SayatAbdikul/Ushqyn/README.md

# Ushqyn (Ұшқын)

> *Ushqyn* — Kazakh for **spark**: tiny, energetic, the genesis of fire.

An INT8 TinyML accelerator targeting the Tang Nano 20K. The selected KWS/VWW
release uses a 27 MHz cached-weight co-issue engine, compiler-managed retention,
SDRAM DMA and a 256-byte UART bridge at 750,000 baud. Its matched board screen
passes **14/14 exact executions**, with median device execution of **41.450 ms
KWS** and **79.898 ms VWW**. The
[selected release](hardware/releases/phase6/selected/README.md) includes the tested
image, source and fixture hashes, build recipe and fresh native validation.
These measurements exclude host loading/readback and remain short-screen results.
Full endurance, board energy and a new architectural contribution remain open.

The earlier reset-corrected G3 on-chip release separately passed MLP → SmallCNN →
MLP with 1,000 exact jobs per stage and a 10,000-image SmallCNN run. The Phase 4
release established exact autonomous SDRAM execution of all 22 KWS and 58 VWW
nodes. See the
[Phase 3 board closure](docs/research/PHASE_3_CLOSURE.md),
[Phase 4 status](docs/research/PHASE_4_STATUS.md),
[Phase 5 status](docs/research/PHASE_5_STATUS.md),
[Phase 6 status](docs/research/PHASE_6_STATUS.md),
[Phase 3 SmallCNN record](docs/research/PHASE_3_STATUS.md) and
[research roadmap](docs/RESEARCH_ROADMAP.md).

## Status

| Workload | Software quality | Board-system RTL | Tang Nano 20K |
|---|---|---|---|
| **MLP** (784→12→32→10 MNIST) | 94.84% static INT8 on 10K | 1,000 exact jobs in Phase 2; retained in current RTL | Two 1,000-job stages exact; 7,316 core cycles |
| **SmallCNN** (Conv→Pool→Conv→Pool→FC) | 96.40% static INT8 on 10K | 10,000 exact jobs, eight layer boundaries checked | Full 10K set + 1K repeated jobs exact; 96.40% accuracy; 118,267 core cycles |
| **KWS / VWW** | Full-set software INT8 quality recorded | Selected engine runs pinned/stress fixtures with fixed and sampled stalled RAM; original layer-oracle evidence retained | Selected 27 MHz image: 14/14 matched exact executions, 41.450 ms KWS / 79.898 ms VWW; short-screen qualification |

The current SmallCNN result uses an independent centered-integer oracle,
source-hashed RTL and a separately calibrated 10,000-image quality evaluation.
The [physical workflow](hardware/PHYSICAL.md) separates device counters,
host latency and remaining measurement/architecture work.

## Selected accelerator

From the repository root:

```bash
make p6-selected-check PYTHON="$PWD/.venv/bin/python3"
make p6-selected-native PYTHON="$PWD/.venv/bin/python3"
```

The first command extracts the pinned bitstream and local generated SDRAM IP,
then verifies all 18 physical source identities, four fixtures and the signed
board records. The second builds the selected RTL and runs KWS/VWW pinned/stress
inputs with fixed RAM and stalled seed 6063. Neither command accesses the board.
The extracted image is `work/phase6/selected-release/selected_27mhz.fs`; a fresh
Gowin build uses `hardware/phase6/build_selected27.tcl`. Follow the
[release instructions](hardware/releases/phase6/selected/README.md) for identity
checks and the distinction between the tested image and a newly routed build.

The latest [implementation decision round](docs/research/PHASE_6_IMPLEMENTATION_DECISION_ROUND_2026_10_01.md)
keeps factorization and resident-preemption experiments as research evidence.
The selected release uses the original validated dense programs.

## Historical v1 architecture

The feature list and workflow below describe the older instruction-set design,
not the current board ABI. Use [physical reproduction](hardware/PHYSICAL.md) for
the active accelerator.

## Key Features (legacy)

- **8-instruction ISA**: `LOAD_V`, `LOAD_M`, `STORE`, `GEMV`, `RELU`, `CONV2D_CFG`, `CONV2D_RUN` (with fused ReLU), `MAXPOOL`
- **Tile-based compute**: 8-element tiles (FPGA) or 32-element tiles (simulation), BSRAM-backed
- **Dynamic per-tensor max-abs quantization**: int32 → int8 with reciprocal-multiply rounding (Q8.24 fixed point)
- **Unified DRAM**: Single 32 KB memory (FPGA: Gowin_SP BRAM + UART loader; sim: `$readmemh` register array)
- **Modular execution units**: One unit per opcode, each independently testable in cocotb
- **Compiler toolchain**: ONNX → assembly → DRAM image, with bit-exact golden-model reference

## Quick Start

### Run the CI tier (no simulator required)
```bash
make ci PYTHON=/absolute/path/to/.venv/bin/python3  # compiler, generated-file and selected-release checks
make help       # full target list
```

This is what `.github/workflows/ci.yml` runs on every push. It locks in:
- the single-source ISA spec (`compiler/isa_spec.py` ↔ `rtl/i_decoder.sv` drift detection),
- the unified ONNX walker (`compile.py` consumes maps from `dram.py`),
- the profile-based `AcceleratorConfig` (sim ↔ fpga),
- and the SmallCNN end-to-end golden contract.

### Run a per-unit cocotb test
```bash
# Conv2D execution: bit-exact match vs golden on relu_flag=0/1
cd test/cocotb_tests
./make_venv.sh TEST_TARGET=conv2d_execution

# MaxPool execution: NCHW layout, bit-exact match vs golden
./make_venv.sh TEST_TARGET=maxpool_execution
```

### Run the SmallCNN end-to-end through compiler + golden model
```bash
cd compiler
python3 train_and_eval_cnn.py     # Train + evaluate (PyTorch + golden model)
```

### Run the trained MLP end-to-end through simulation RTL
```bash
cd test/heavy_test_fpga
make run_test NUM_IMAGES=20         # Full pipeline through FPGA-tier RTL
```

### Compile your own ONNX model
```bash
cd compiler
python3 compile.py model.onnx assembly_code.asm
python3 -c "from assembler import assemble_file; assemble_file('assembly_code.asm', 'output.hex')"
```

## Project Structure

```
ushqyn/
├── src/                            # FPGA synthesis source (Gowin EDA)
│   ├── fpga_top.sv                # FPGA top-level (UART + accelerator)
│   ├── tinyml_accelerator_top_fpga.sv
│   ├── top_gemv.sv                # GEMV core (BSRAM-optimized)
│   ├── simple_memory.sv           # Gowin_SP BRAM + UART loader
│   ├── Gowin_SDPB_32.sv           # BSRAM IP wrapper
│   └── ...                         # Decoder, exec units, UART, etc.
│
├── rtl/                            # Simulation RTL (Verilator + cocotb)
│   ├── tinyml_accelerator_top.sv  # Sim top
│   ├── i_decoder.sv               # 8-opcode decoder (incl. CONV2D_CFG/RUN, MAXPOOL)
│   ├── accelerator_config_pkg.sv  # (gitignored — regenerated by generate_config.py)
│   ├── execution_unit/            # CNN-capable simulation execution path
│   │   ├── modular_execution_unit.sv
│   │   ├── conv2d_execution.sv    # 2D convolution + fused ReLU + per-tensor quant
│   │   ├── maxpool_execution.sv   # Sliding-window NCHW max-pool
│   │   ├── gemv_execution.sv      # FC / Gemm path
│   │   ├── load_execution.sv, store_execution.sv, relu_execution.sv
│   │   └── buffer_controller.sv
│   └── fpga_modules/              # FPGA-targeted simulation mocks (MLP only today)
│       ├── gemv_unit_core.sv      # BSRAM-backed GEMV core
│       ├── Gowin_SDPB_32.sv       # Sim mock of Gowin BSRAM
│       └── ...                     # No conv2d/maxpool yet — see "FPGA path" below
│
├── compiler/                       # Python toolchain
│   ├── compile.py                 # ONNX → assembly
│   ├── assembler.py               # Assembly → 64-bit machine code
│   ├── disassembler.py            # Reverse: bytes → mnemonic
│   ├── dram.py                    # save_all_initializers_to_dram + DRAM hex writer
│   ├── golden_model.py            # Bit-exact Python reference (RTL contract)
│   ├── helper_functions.py        # quantize_int32_to_int8_rtl_exact + ONNX helpers
│   ├── model.py                   # MLP and SmallCNN PyTorch definitions
│   ├── train_and_eval_cnn.py      # Train SmallCNN, eval through full toolchain
│   └── test_cnn_golden.py         # End-to-end pytest (LOAD_V count, FC bias DRAM, NumPy shadow chain)
│
├── test/
│   ├── cocotb_tests/              # Per-unit cocotb tests
│   │   ├── test_conv2d_execution.py     # NEW — Patch F regression
│   │   ├── test_maxpool_execution.py    # NEW — Patch G regression
│   │   ├── test_execution_unit.py       # MLP integration
│   │   └── test_golden_comparison.py    # Top-level MLP cocotb
│   ├── conv2d_execution_tb.cpp / _wrapper.sv    # Verilator C++ tb
│   ├── maxpool_execution_tb.cpp / _wrapper.sv   # Verilator C++ tb
│   ├── heavy_test_fpga/           # Full MNIST integration on FPGA-tier RTL (MLP)
│   ├── heavy_test/                # Full MNIST on simulation RTL (sim_only path)
│   └── new_unit_tests/            # Verilator C++ standalone unit tests
│
├── memory_tools/                   # UART loaders / readers for FPGA
├── docs/
│   ├── RTL_ARCHITECTURE.md        # Detailed RTL architecture
│   └── diagrams/                  # System diagrams
└── generate_config.py              # Source of truth for both rtl/accelerator_config_pkg.sv and compiler/accelerator_config.py
```

## Two RTL paths

| Path | Top module | Workloads | Targeted at |
|---|---|---|---|
| `rtl/` + `rtl/execution_unit/` | `tinyml_accelerator_top.sv` | **MLP + CNN** | Verilator/cocotb simulation |
| `rtl/fpga_modules/` (+ `src/` for synthesis) | `tinyml_accelerator_top_fpga.sv` (+ `fpga_top.sv`) | **MLP only** today | Gowin GW2AR-18 (Tang Nano 20K) |

The simulation RTL has the full 8-opcode CNN path. The FPGA path mirrors the MLP subset (`gemv_unit_core.sv` + supporting modules) at smaller TILE_ELEMS=8 and is the only one currently synthesizable. Bringing the CNN ops to FPGA requires porting `conv2d_execution.sv` / `maxpool_execution.sv` into `rtl/fpga_modules/` with TILE_ELEMS=8 and a Gowin BSRAM-backed accumulator (~2–4 days of focused work).

## Instruction Set

| Opcode | Mnemonic | Description | Notes |
|---|---|---|---|
| 0x00 | NOP | No-op (program terminator) | Zero word ends fetch |
| 0x01 | LOAD_V | Load vector from DRAM into a vector buffer | 18-bit length |
| 0x02 | LOAD_M | Load matrix from DRAM into a matrix buffer | rows × cols, cols padded to TILE_ELEMS |
| 0x03 | STORE | Write a vector buffer back to DRAM | 18-bit length |
| 0x04 | GEMV | `dest = quant(W·x + b)` | int32 accum, per-tensor max-abs scale |
| 0x05 | RELU | Element-wise `max(0, x)` | Standalone (used for FC ReLU) |
| 0x06 | CONV2D_CFG | Latch convolution geometry (fmap, channels, kernel, stride, pad) | Precedes CONV2D_RUN |
| 0x07 | CONV2D_RUN | Execute 2D convolution + bias + quant; `relu_flag` (bit 25) optionally fuses ReLU | Reads geometry from prior CONV2D_CFG |
| 0x08 | MAXPOOL | Sliding-window NCHW max pool | Operates on int8 directly, no rescale |

**Instruction encoding**: 64-bit little-endian word, opcode in bits [4:0]. The single source of truth for every opcode and field bit-layout is `compiler/isa_spec.py`. The assembler, disassembler, the golden-model decoder, and `rtl/i_decoder.sv` (regenerated by `tools/generate_i_decoder.py`) all read from that file. To add or change an opcode, edit `isa_spec.OPCODES`, run `python tools/generate_i_decoder.py`, and re-run `compiler/test_isa_spec.py` to confirm cross-consistency. See [docs/RTL_ARCHITECTURE.md](docs/RTL_ARCHITECTURE.md) for the per-opcode bit-layout tables.

## Module Hierarchy

```
tinyml_accelerator_top
├── fetch_unit                    Fetches 64-bit instructions from DRAM
├── i_decoder                     Decodes opcode + per-op fields
└── modular_execution_unit
    ├── buffer_controller         Vector + matrix buffer file management
    │   └── buffer_file (×N)      Tile-indexed BSRAM-backed buffers
    ├── load_execution            LOAD_V / LOAD_M orchestration
    │   ├── load_v.sv
    │   └── load_m.sv
    ├── gemv_execution            FC / Gemm tile streaming
    │   └── (sim) top_gemv  /  (FPGA) gemv_unit_core
    │       ├── pe.sv (×TILE_ELEMS)        — int8 × int8 multiplier
    │       ├── scale_calculator.sv         — recip = (127<<24)/max_abs
    │       └── quantizer_pipeline.sv       — int32 × Q8.24 → round → clamp int8
    ├── relu_execution            Standalone ReLU (FC outputs only)
    ├── conv2d_execution          2D conv + bias + quant (+ optional fused ReLU)
    │                              [simulation RTL only — not yet in fpga_modules/]
    ├── maxpool_execution         Sliding-window max pool (NCHW)
    │                              [simulation RTL only — not yet in fpga_modules/]
    └── store_execution           Buffer → DRAM write-back
```

## Compiler Toolchain

```
ONNX model
    │
    ▼
compile.py            (topological walk, emits assembly)
    │
    ▼
assembly file
    │
    ▼
assembler.py          (mnemonic → 64-bit machine code)
    │
    ▼
dram.py               (save_all_initializers_to_dram: weights, biases, instructions
                       packed into a single dram.hex DRAM image)
    │
    ▼
dram.hex              ──→  Loaded into RTL via $readmemh (sim) or UART (FPGA)
                      ──→  Executed by golden_model.execute_program (Python)
```

The compiler walks the ONNX graph in topological order, emits per-op instructions, and lays out weights/biases in a single shared DRAM region with a deterministic offset scheme (`compiler/accelerator_config.py::AcceleratorConfig`). The Python golden model decodes the same instruction stream and is **bit-exact** with the RTL on every operation — it serves as the contract that the RTL must satisfy.

## DRAM Memory Map

| Region | Default address | Contents |
|---|---|---|
| Instructions | `0x0000` | Program code (fetched by `fetch_unit`) |
| Inputs | `0x00C0` | Per-image input vector (loaded via LOAD_V) |
| Biases | `0x04C0` | All biases in topological order: conv1 → conv2 → … → fc |
| Outputs | `0x08C0` | Inference results (written by STORE) |
| FC Weights | `0x0940` | Gemm/MatMul weights, padded to TILE_ELEMS columns |
| Conv Weights | `0x3000` | Conv weights `[out_C, in_C·kH·kW]`, padded to TILE_ELEMS columns |

Addresses live in `generate_config.py::DEFAULT_CONFIG` and are emitted to both `rtl/accelerator_config_pkg.sv` and `compiler/accelerator_config.py`.

## Performance

### Simulation RTL (32-element tiles, CNN-capable)
- Bit-exact match against `compiler/golden_model.py` on the SmallCNN.
- ~1 M cycles/image at simulation rate (~5–10 k sim cycles/sec wall on a typical laptop with cocotb tracing on).

### FPGA build (Gowin GW2AR-18, MLP only)

| Metric | Value |
|---|---:|
| **Fmax** | 89.2 MHz |
| **Cycles / image (MLP)** | 25,470 |
| **Latency** | 0.286 ms/img (~3,500 img/s) |
| **LUT4** | 8,640 / 20,736 (42 %) |
| **BSRAM (18 Kb blocks)** | 43 / 46 (94 %) |
| **DSP** | 5 (1× MULT36X36 + 4× MULTADDALU18X18) |
| **MNIST accuracy** | 95 % on 10 000 images, 100 % bit-exact vs golden |

### Optimization timeline (MLP path on FPGA)

| Step | Cycles | Fmax | Notes |
|---|---:|---:|---|
| Baseline (BSRAM accum) | 43 996 | 67 MHz | Initial FPGA bring-up |
| FIND_MAX / CLEAR fix | 34 942 | — | −20.6 % cycles |
| A1–A4 (pipeline stages) | 36 221 | 84 MHz | +25 % Fmax |
| A6 (x_mem → BSRAM) | 37 501 | 91 MHz | +36 % Fmax |
| B1 (pack x_mem 4:1) | 29 301 | 86 MHz | −21.9 % cycles |
| B2 (prefetch x tile) | 25 470 | 89 MHz | −13.1 % cycles |

### CNN compiler-fix series (Patches A–D, F–J — 2026)

The CNN-capable simulation path was brought up over a sequence of focused patches:

| Patch | Scope | Result |
|---|---|---|
| **A** | `golden_model.py` cleanup; `disassembler.py` CNN ops | Lint clean, debug residue removed |
| **B** | Compiler bias data-flow rewrite (atomic): unified DRAM walker, no duplicate `LOAD_V`, TILE_ELEMS-driven padding | Strengthened end-to-end test (`test_cnn_golden.py`) goes red→green |
| **C** | Cross-link docstrings between `gemv` / `conv2d` / `load_m` | — |
| **D** | Conv→Relu lookahead skips non-consumer nodes (Constant) | Compiler emits correct `relu_flag` for both convs |
| **F** | RTL `relu_flag` plumbing (`i_decoder` → top → exec unit → conv2d) | 2/2 cocotb tests bit-exact vs golden |
| **G** | `maxpool_execution.sv` NCHW layout (was NHWC; mismatched conv2d output) | 2/2 cocotb tests bit-exact vs golden |
| **H** | `i_decoder` length width 10 → 18 bits (LOAD_V/STORE) | Lint clean; F+G regressions hold |
| **I** | `conv2d_execution.sv` `accum_ram` parameterized + overflow `$error` | F regression holds |
| **J** | `VECTOR_BUFFER_WIDTH` 8192 → 32768 + thread package param through exec units | **End-to-end RTL ↔ Golden bit-exact** on SmallCNN MNIST |

## Documentation

- **[docs/RTL_ARCHITECTURE.md](docs/RTL_ARCHITECTURE.md)** — Detailed RTL architecture, instruction-format bit layouts, FSM diagrams, optimization history
- **[docs/README.md](docs/README.md)** — Documentation index
- **[rtl/execution_unit/README.md](rtl/execution_unit/README.md)** — Execution-unit module guide (load / gemv / relu / store / **conv2d / maxpool**)
- **[test/heavy_test/README.md](test/heavy_test/README.md)** — Full-MNIST validation guide
- **[test/heavy_test_fpga/README.md](test/heavy_test_fpga/README.md)** — FPGA-tier simulation guide
- **[test/cocotb_tests/README.md](test/cocotb_tests/README.md)** — Per-unit cocotb test suite
- **[memory_tools/README.md](memory_tools/README.md)** — UART loader / reader

## Future Work

- **CNN on FPGA** — port `conv2d_execution.sv` and `maxpool_execution.sv` to `rtl/fpga_modules/` with TILE_ELEMS=8 and Gowin BSRAM-backed `accum_ram`. Estimated ~2–4 days of porting + bring-up.
- **Quantization quality** — per-channel weight quantization, asymmetric int8 for ReLU outputs, and calibration-based static activation scales would tighten the int8↔float32 gap on deeper networks. The SmallCNN sits at quantization noise today; bigger nets will need this.
- **Larger networks** — to run anything beyond a 2-conv-layer SmallCNN class, the ISA needs widening: `fmap_h`/`fmap_w` from 6 → ≥9 bits, channel fields from 6 → ≥10 bits, and `ADDR_WIDTH` from 16 → ≥24 (4 MB+ DRAM via PSRAM on FPGA). Tiny-YOLO targets are not feasible on the current ISA generation.

---

**Status (2026-05)**: Simulation RTL bit-exact against the Python golden model on a trained SmallCNN; FPGA build at 89 MHz with full-MNIST MLP validation. CNN ops on FPGA is the next bring-up milestone.
