SayatAbdikul/Ushqyn/hardware/PHYSICAL.md

# Tang Nano 20K physical validation

## Selected Phase 6 KWS/VWW release

The current fastest board-tested KWS/VWW image is the
[selected 27 MHz release](releases/phase6/selected/README.md), SHA256
`eaf74e99519d3dfac876bf21e9087dd005071bb8b8682d3f8ae6fb23bb76644d`.
It passes a 14-execution matched board screen with 41.450 ms KWS and 79.898 ms
VWW median device time. The release pins the cached-weight co-issue engine,
27 MHz host/PLL, 256-byte UART bridge at 750,000 baud and exact dense programs.

Run `make p6-selected-check PYTHON="$PWD/.venv/bin/python3"` to verify sources,
fixtures and signed records and extract `work/phase6/selected-release/selected_27mhz.fs`.
The relocation-safe fresh-build recipe is `hardware/phase6/build_selected27.tcl`.
No board is accessed by that verification or `make p6-selected-native`.
For future physical reproduction, supply the exact selected `.fs` and the
release's `fixtures/` directories to the Phase 6 board runner. A newly routed
image needs its own validation and must not inherit the archived measurements.
The phase-specific instructions below preserve the earlier release workflows.

## Phase 3 on-chip release

Use active target ID **8196** and the Phase 3 closure image at
`hardware/releases/phase3-closure/tinyml_v6_tang20k.fs`. The original
Phase 2–4 kernel-only bitstreams have the wrong KEY1 polarity; the reset-corrected v4
and line-buffer v5 images remain archived comparison baselines. The
[G3 closure record](../docs/research/PHASE_3_CLOSURE.md) identifies the
current source-matched board release.
Its SHA256 is
`4e3d6e9a47d872bfb65134fff9cdbb25c11dfc22bcbbf39db7d2c1ac9b61c0da`.

The board's KEY1 at pin 88 is **active high**. The wrapper initializes its
reset synchronizer at configuration, asserts reset while KEY1 is pressed,
and releases it after three clock edges. No button press is needed to begin
using the accelerator. This follows the inversion in Sipeed's
[UART reference](https://github.com/sipeed/TangNano-20K-example/blob/main/uart/src/uart_top.v).

## Build and program

Install the compiler/test environment and `tools/physical/requirements.txt`.
This execution used Gowin Education V1.9.11.03, Verilator 5.044,
openFPGALoader 1.1.1 and pyserial 3.5. From the repository root:

```sh
export USHQYN_ROOT="$PWD"
export DYLD_FRAMEWORK_PATH=/Applications/GowinIDE.app/Contents/Resources/Gowin_EDA/IDE/lib
export DYLD_LIBRARY_PATH="$DYLD_FRAMEWORK_PATH"
export GOWIN_SH=/Applications/GowinIDE.app/Contents/Resources/Gowin_EDA/IDE/bin/gw_sh
.venv/bin/python3 tools/phase2/build_gowin.py work/physical/new-build
.venv/bin/python3 tools/phase2/generate_target.py --check \
  --manifest work/physical/new-build/source-manifest.json
cd work/physical/new-build
"$GOWIN_SH" build.tcl
cd "$USHQYN_ROOT"
openFPGALoader -b tangnano20k --ftdi-serial 2025030317 --freq 2500000 -m -v \
  work/physical/new-build/tinyml_v2/impl/pnr/tinyml_v2.fs
```

For the frozen artifact, substitute
`hardware/releases/phase3-closure/tinyml_v6_tang20k.fs`. The test commands
below assume that frozen artifact was programmed. If you program a new build,
pass that exact new `.fs` to every `--bitstream` argument so the result records
its actual supplied hash. `-m` configures temporary
FPGA SRAM; the flash image is unchanged and returns after a power cycle.

The previous Phase 3 line-buffer image is separately archived at
`hardware/releases/phase3-linebuffer/tinyml_v5_candidate.fs` (SHA256
`fc6c90d3fb162eadfa042ecbfc1d89277c3a7a0af09fbc44a377c1fe90c81164`).
It passed RTL simulation, Gowin routing and 13,000 exact physical inferences
plus 61 diagnostics. Its
[separate board record](../docs/research/PHASE_3_LINEBUFFER_PHYSICAL.md)
documents that earlier rerun. The closure v6 image passed the same physical
suite and is the active release. Keep new runs in their own report directory.

Close UART sessions before programming. Keep the successful programmer log
with the bitstream SHA256. The UART protocol reports the ABI, but cannot
read back a configuration hash.

The tested USB debugger serial is `2025030317`. On this Mac,
`/dev/cu.usbserial-20250303171` is the FPGA UART; channel `...170` is JTAG.
Other boards/hosts may enumerate differently. Pins are clock 4, KEY1 88,
UART RX 70 and TX 69. The FPGA part is `GW2AR-LV18QN88C8/I7`, revision C
as detected by JTAG; the PCB revision is unknown.

The six user LEDs are active-low in this accelerator image. `led[0]` lights
while the engine is busy; `led[4]` pulses for one clock at a layer boundary;
`led[5]` lights when the engine reports a nonzero error. `led[1]` through
`led[3]` stay off. A high output pin therefore means the corresponding LED
is off.

## Repeat the checks

Prepare the current-target model fixtures with the commands in
[Phase 2](PHASE_2.md) and [Phase 3](PHASE_3.md). The MLP preparation requires
the original locally held weight file. Then:

```sh
.venv/bin/python3 tools/physical/run_models.py \
  --port /dev/cu.usbserial-20250303171 \
  --fixture work/phase2/mlp --fixture work/phase3/smallcnn \
  --fixture work/phase2/mlp --jobs 1000 \
  --bitstream hardware/releases/phase3-closure/tinyml_v6_tang20k.fs \
  --report work/physical/model-switch.json

.venv/bin/python3 tools/physical/run_checks.py \
  --port /dev/cu.usbserial-20250303171 \
  --fixture work/phase2/mlp --fixture work/phase3/smallcnn \
  --bitstream hardware/releases/phase3-closure/tinyml_v6_tang20k.fs \
  --report work/physical/checks.json
```

`run_checks.py` verifies six patterns across all 32 KiB, malformed-frame
recovery, busy ownership, ABORT/RESET, nine directed kernel geometries
(three runs each), and every MLP/SmallCNN layer for three inputs. Individual
layer counters include that isolated RUN's startup/HALT overhead; they are
not additive measurements of uninterrupted whole-model execution.

For the complete SmallCNN accuracy set, either generate a new 10,000-case
fixture with `tools/phase3/prepare_smallcnn.py --jobs 10000`, or join the
already frozen full-set oracle to the current fixture:

```sh
.venv/bin/python3 tools/physical/prepare_smallcnn_quality.py
.venv/bin/python3 tools/physical/run_models.py \
  --port /dev/cu.usbserial-20250303171 \
  --fixture work/physical/smallcnn-full --jobs 10000 \
  --bitstream hardware/releases/phase3-closure/tinyml_v6_tang20k.fs \
  --report work/physical/smallcnn-full.json
```

The join checks software image, model, calibration and dataset identity,
all overlapping inputs/logits, and fresh independent oracle results for
the first, middle and final sample. It preserves cached-oracle hashes.
All runners save partial failure evidence and never automatically repeat
an ambiguous RUN. Use a separate report path for each new attempt.

For minimal transport bring-up, build `hardware/bringup/build.tcl` in a
fresh directory, program its `uart_loopback.fs`, then run
`tools/research/uart_readback.py --port DEVICE --report OUTPUT.json`.
It tests all byte values plus 1,024 seeded random bytes. Restore the
accelerator bitstream before running the model commands.

For the separate Phase 4 SDRAM/DMA diagnostic, generate the pinned Gowin HS
IP as described in [the SDRAM README](phase4_sdram/README.md), build
`hardware/phase4_sdram/build_dma.tcl` in a fresh directory, then run:

```sh
.venv/bin/python3 tools/physical/run_phase4_dma_smoke.py \
  --bitstream hardware/releases/phase4-sdram/hs_dma_full_tile.fs \
  --report work/physical/phase4-dma-repeat.json
```

The runner temporarily programs the diagnostic image, verifies its UART
result and records the exact source/bitstream hashes and DMA cycle counts.
The archived [board result](../docs/research/evidence/phase4/physical-sdram-dma.json)
passed a 32-KiB full-tile round trip and a 13-byte bank crossing. It is not
the host-command accelerator image; reprogram the Phase 3 release before
using `run_models.py` or `run_checks.py`. A USB power cycle erases the temporary
image. If JTAG programming works but UART loopback is silent, power-cycle the
USB connection, reprogram the image and rerun loopback.

## Phase 4 autonomous SDRAM-connected release

The current image is `hardware/releases/phase4-sdram/hs_tiled_autonomous.fs`,
SHA256 `ea4eed105933e87d308d42b4bfa581010e843c9c9b9f94e9c9e8e852c19b98fb`.
It operates at 20.25 MHz and includes the command sequencer, 32-KiB engine
scratchpad, tile DMA and 64-byte burst SDRAM adapter. G4's physical results
and limits are recorded in [Phase 4 closure](../docs/research/PHASE_4_STATUS.md).

```sh
openFPGALoader -b tangnano20k --ftdi-serial 2025030317 --freq 2500000 -m -v \
  hardware/releases/phase4-sdram/hs_tiled_autonomous.fs
.venv/bin/python3 tools/phase4/run_physical_sequence.py --model kws \
  --bitstream hardware/releases/phase4-sdram/hs_tiled_autonomous.fs \
  --report work/phase4/repeat-autonomous-kws.json
.venv/bin/python3 tools/phase4/run_physical_sequence.py --model vww \
  --bitstream hardware/releases/phase4-sdram/hs_tiled_autonomous.fs \
  --report work/phase4/repeat-autonomous-vww.json
.venv/bin/python3 tools/phase4/audit_phase4_closure.py
```

Keep the same programmed image for both workloads. The runner verifies model,
calibration and fixture hashes, compares all intermediate snapshots, and then
measures sequential/overlap modes on identical tile placements. The last command
checks archived evidence; new reports should be archived and audited explicitly.
See [AUTONOMOUS.md](phase4_sdram/AUTONOMOUS.md) for interface/measurement details.
The older `hs_tiled_host_overlap.fs` remains an archived diagnostic baseline.

## Measurement boundary

The Phase 3 reports retain raw INT8 outputs, physical device counters and host
wall times. Core milliseconds derived from counters use the nominal
27-MHz clock; no independent clock instrument was available. Host job time
covers quantized-input upload, RUN/status polling and output readback;
it excludes preprocessing, argmax, report writing and model loading.
Model load plus full memory readback is reported separately. These bring-up
runs have no explicit warm-up exclusion and are not a tuned baseline comparison.

No power instrument is available, so board power/energy are unmeasured.
The Phase 3 bitstream has no SDRAM controller or integrated DMA; the separate
Phase 4 image now does and passes one full input per KWS/VWW graph. Neither
image establishes full-set primary-model accuracy, energy efficiency or the
remaining research novelty/baseline gates. See the
[physical results](../docs/research/PHYSICAL_BOARD_STATUS.md).
