SayatAbdikul/Ushqyn/docs/research/PHASE_6_DECISION_ROUND_PRIOR_ART_2026_10_01.md

# Prior-art gate for the factorization and resident-preemption decision round

Checked 1 October 2026. This is a focused mechanism comparison, not an exhaustive literature review. The experiments test utility and physical feasibility; this review does not certify that an untested combination is novel.

| Primary source | Established mechanism | Consequence for this project |
| --- | --- | --- |
| [PREMA, HPCA 2020](https://arxiv.org/abs/1909.04548) | Preemptible neural processing units with predictive multi-task scheduling for high-priority inference latency and throughput. | Generic neural-accelerator preemption and latency-aware sharing are established. |
| [ART, GLSVLSI 2025, author description](https://peipeizhou-eecs.github.io/publication/2025_glsvlsi_art/) and [author slides](https://peipeizhou-eecs.github.io/publication/2025_glsvlsi_art/ART_GLSVLSI25_ShareVersion.pdf) | FPGA accelerator transformation, resident EDF scheduling, save/resume, schedulability analysis, and preemption-point placement. The slides describe layer segmentation with intermediate data in DDR. | A resident controller plus selected interruption points is insufficient as a novelty claim. The full ACM paper was not accessible in this screen. |
| [DERCA, RTSS 2025, full author paper](https://peipeizhou-eecs.github.io/publication/2025_rtss_clare/2025_rtss_clare.pdf) and [artifact](https://github.com/arc-research-lab/DERCA) | Intra-layer preemption, an on-chip deterministic EDF scheduler, persisting versus recomputing intermediate state, and joint point-placement/dataflow optimization with schedulability analysis. | This is a closer comparison than PREMA. Fine-grained boundaries, state-cost awareness, autonomous control, and joint placement alone are already covered. |
| [Texas Instruments TIDL, official preemption documentation](https://github.com/TexasInstruments/edgeai-tidl-tools/blob/master/docs/preemption.md) | Layer-boundary context switching, priorities, and a configurable delay window for choosing efficient switch locations. | Waiting for a cheaper context-switch point is an ordinary strong control. Documentation does not disclose enough internals to reproduce its policy exactly. |
| [Deft, Middleware 2023, author abstract](https://research.ibm.com/publications/towards-optimal-preemptive-gpu-time-sharing-for-edge-model-serving) | Workload/SLO-dependent insertion of synchronization points using profiled inference and preemption costs. | Trading inference overhead against interruption delay through point frequency is established beyond FPGA systems. |
| [Quilt, Journal of Systems Architecture 2026, university publication record](https://yonsei.elsevierpure.com/en/publications/peak-memory-aware-partitioning-and-scheduling-for-multi-tenant-dn/) | Peak-memory-aware model partitioning, multi-model task scheduling, and a pool for tensors shared between tasks. | Memory-aware graph partitioning and scheduling are established. The publisher full text was inaccessible; this comparison is abstract-level. |
| [TinyML approximate matrix decomposition, 2026, author manuscript](https://arxiv.org/abs/2604.16113) | Post-training decomposition and exploration of resulting multiplierless FPGA accelerators under accuracy and resource constraints. | Decomposition plus FPGA co-design needs a more specific new mechanism and a fair optimized control. |
| [TeMCO, ICPP 2024, full author paper](https://www.corelab.or.kr/Pubs/icpp24_teMCO.pdf) | Keeping reduced internal tensors across decomposed layers, activation fusion, and skip connections to reduce inference memory. | Reduced intermediate storage and decomposition-aware fusion are established compiler techniques. |

## Remaining question and required comparison

The narrow candidate question is whether allocating a finite resident program store jointly to ordinary job code, allowed interruption sites, checkpoint metadata, and executable save/restore sequences changes the achievable blocking/overhead frontier on a small shared scratchpad accelerator. The experiment uses a 32 KiB program capacity and a 32 KiB data scratchpad with one shared 64-bit port.

This constraint does not by itself establish novelty. DERCA already considers platform constraints and state movement. Its scalability discussion explicitly charges 24 bytes of on-chip metadata per non-preemptive region. A defensible contribution would require demonstrating an additional mechanism or result beyond a straightforward resource-budgeted application of its ideas, and checking the full algorithm/artifact before claiming the finite-program formulation is absent. The present bounded policy comparison uses ordinary boundaries and uniform splitting with the same budget optimizer and live-state costs, making them strong controls.

For factors, the required control is the strongest equivalent strip/residency implementation of the original dense graph, followed by ordinary optimized factor execution. Existing quality estimates belong to the frozen factors. Further rank or training selection must use an appropriate development split and a fresh evaluation protocol.

## Evidence levels

Native exact-output tests establish correctness for the tested arithmetic, inputs, and abstract RAM transactions. Synthesis and route establish implementation feasibility and timing for their pinned sources. Trace scheduling establishes behavior under its declared cost model. Neither sampled RAM stalls nor a finite arrival grid proves physical worst-case schedulability. Board and energy evaluation follow only if an implementation and controlled benefit survive this round.
