SayatAbdikul/Ushqyn/docs/research/PHASE_5_STATUS.md

# Phase 5 working record — updated 2026-09-26

**Physical addendum:** the SDRAM-connected board passed complete, byte-exact
KWS and VWW inputs with every intermediate node checked under the Phase 4
release. A new dual-resident Phase 5 release then passed four strictly
alternating KWS/VWW jobs with byte-exact raw INT8 logits and no reflash or
model reload between jobs. Its [route and smoke evidence](evidence/phase5/dual-resident-route.json)
pins the image and reports. G4 remains closed. Four jobs do not establish full
accuracy or the 10,000-job stability gate.

**P5 is in progress; G5 is open.** Both frozen accuracy payloads are now
materialized and hash-verified: 4,890 KWS samples and 10,961 VWW samples.
The 10,000-job physical switch campaign has started, but its final result is
not yet available. There is no complete primary board accuracy result, AD
INT8/board full-set result, or measured B1/B2/B3 comparison. The physical smoke proves
programmable dual-model execution, not a Phase 5 or SOTA accelerator claim.

## Reproducible B01 switch workload

`make p5-plan` reads the frozen accuracy-record manifests, rejects duplicate
IDs and calibration overlap, and creates a deterministic 10,000-job plan.
The jobs strictly alternate KWS and VWW. KWS has only 4,890 accuracy samples,
so its 5,000 stress jobs include every sample once and 110 repeated samples;
VWW uses 5,000 distinct samples from its 10,961-sample accuracy split. A
fixed pseudorandom permutation avoids an index-order subset. Every job pins
the sample ID, source index and preprocessed-feature SHA256. The compact
[plan evidence](evidence/phase5/switch-plan.json) records the JSONL SHA256,
manifest hashes, seed and selection counts. Generate the complete plan with:

```sh
python3 tools/phase5/schedule.py --output work/phase5/balanced-jobs.jsonl
```

This is a **planned** switch stress sequence; the separate full board run is
in progress. Full
accuracy must separately process all 4,890 KWS and all 10,961 VWW samples;
neither the stress subset nor software-v2 scores certify board quality. When
the board path exists, run the *same bitstream* throughout, record model-load
and reflash events, compare every raw INT8 logit with the independent integer
reference, and keep classification correctness separate from implementation
mismatches. Preprocessing and host argmax must follow the frozen boundaries.

## Evidence inventory

The frozen evaluation payloads were rebuilt from the pinned raw archives with
`tools/phase5/materialize_accuracy.py`; it verifies every raw-file and feature
hash before accepting the exact split archive SHA256. The accepted local NPZ
hashes are KWS `66f6b5cd75410e7b7b5d483dab8e48c363256822a066689fe895041c7941b8ac`
and VWW `fc57a65876dae96143e22296c334e4a82cd3dba2b99b8299b28fc337d41fb2b0`.
The source test archives and extracted datasets remain local `work/` artifacts.
The dual-resident release bitstream is
[`hardware/releases/phase5/dual_resident_750k.fs`](../../hardware/releases/phase5/dual_resident_750k.fs).

`make p5-audit` reruns the plan regression tests and the
[readiness audit](evidence/phase5/readiness.json). The audit checks the
kernel bitstream and canonical inventory SHA256 values against Phase 4's
frozen evidence. The later on-chip physical release and its raw artifact hashes are checked separately; that clears board-access readiness without claiming complete primary-model execution. It also checks that the existing full-set **software**
accuracy reports match the pinned split counts and hashes. Current software
results are KWS 4,514/4,890 (92.31%) and VWW 9,239/10,961 (84.29%). They
are not hardware measurements; the VWW split is research validation, not an
official MLPerf certification.

The current readiness audit recognizes the dual-resident routed release and
four-job physical smoke. It checks archived artifact hashes while keeping the
complete board accuracy, 10,000-job sequence, AD and matched-baseline gates
open. File presence alone cannot certify future results. The `g5_certified`
field remains false.
The current 32-KiB scratchpad is below even KWS's 33,216 bytes of packed
persistent parameters; VWW needs 260,640 bytes of such parameters and has
six full-layer input/output pairs that exceed the scratchpad. Tiling and real
external memory are necessary for these pinned graphs.

## B02 and B03 comparison contract

Preliminary B1 and B2 command/payload candidates are generated by
`tools/phase5/prepare_baseline_candidates.py` from the same frozen INT8 models.
B1 uses largest-fitting layer-wise tiles and serialized DMA; B2 prefers
alternate 16-KiB live regions with legal prefetch and falls back to 32 KiB
where needed. The candidate manifest records model hashes, transfer volume,
scratch use and command counts. The physical sample probe is prepared, but it
has not run and does not establish a fair, fully tuned B03 comparison. B3's
actual DeFiNES adaptation remains unimplemented. The current descriptor path
keeps layers separated by SDRAM and tiles output channels; it cannot yet
express DeFiNES's spatial cross-layer tiles or horizontal-overlap
cache/recompute modes. A faithful B3 therefore requires compiler/RTL support
or an explicit, justified restricted-policy comparison, not a relabeling of B2.

AD remains a planned third FPGA workload. The frozen ToyCar model has a 640-element
input and reconstruction output. [Phase 0 closure](PHASE_0_CLOSURE.md) now pins
all 248 evaluation recordings and 112 calibration recordings, with source-float
pooled ROC-AUC 0.880423 on the research reconstruction. This does not close B02's
INT8/physical quality requirement. B02 requires the
exact linear reconstruction output, the pinned anomaly score and scoring-time
boundary, streamed weights, independent integer comparisons and complete-set
ROC-AUC ≥0.85. Do not replace this with classification argmax or a synthetic
subset result.

For B03, use one frozen model, weight set, INT8 arithmetic, eight-lane engine,
host boundary, scratchpad/SDRAM capacity, clock and board setup for all three
policies. B1 is a tuned conventional layer-wise tiled schedule; B2 adds only
physical live-range/bank placement to that baseline; B3 is an adaptation of
the pinned DeFiNES policy described in the
[novelty decision](novelty_matrix.md). Preserve feasible cache/recompute
modes, record any legality repair and its cost, and give each policy the same
declared wall-clock tuning budget. Publish all feasible candidates and
failures. Report complete-model latency, host and DMA time, bytes transferred,
routed resources, achieved common clock, exact output mismatches and full-set
accuracy for both KWS and VWW. No comparative speedup or energy number exists
yet. A post-synthesis report supplies resource/timing estimates, not live
SDRAM behavior, end-to-end latency or power.

## Work required to close G5

1. G4 is now closed: autonomous hybrid ping-pong, burst DMA and the static
   latency model pass their physical gates. Use the new release and preserve
   its exact source/bitstream identity for the Phase 5 campaigns.
2. Materialize the frozen KWS/VWW model images and accuracy payloads using
   [the pinned benchmark recipes](../../benchmarks/README.md). Validate all
   source, preprocessing and split hashes before using them.
3. Run the two complete primary accuracy sets and the pinned 10,000-job
   alternating sequence on one release bitstream, with exact integer output
   comparison, no reflashing and repeatability evidence.
4. Implement and tune B1/B2/B3 fairly on that same hardware; report all
   complete-model results and infeasible cases. This is mandatory for G5.
5. Run AD with reconstruction scoring and full ROC-AUC to complete the planned
   suite, then assess the G5 gate. Physical board measurements remain necessary
   for deployment, latency and energy claims.

## Current dual-resident physical measurement

The routed GW2AR-LV18QN88C8/I7 image has SHA256
`9a0cf45477b8602b97a2ab81cbf5ae0e09a8c95bbfcd174cf1998a1b938e5ed1`.
At the actual 20.25-MHz core clock, its route reports 22.668-MHz Fmax,
14,463/20,736 logic cells, 34/46 BSRAM and 19.75/24 DSP. The four-job smoke
measured median **5.688 million KWS core cycles** (about 281 ms) and
**18.301 million VWW core cycles** (about 904 ms), with median host-inclusive
UART wall times 0.348 s and 3.517 s respectively. These are measured smoke
latencies, not complete-set distributions. They miss the roadmap's provisional
20-ms KWS and 100-ms VWW execution targets by a wide margin. No external power
meter is available; the Gowin power report is an estimate only.
