SayatAbdikul/Ushqyn/docs/research/PARALLEL_ARCHITECTURE_EXPERIMENTS_2026_09_28.md

# Parallel architecture experiment screens — 28 September 2026

This report follows the [project architecture review](ARCHITECTURE_NOVELTY_REVIEW_2026_09_28.md) and the completed agent's [engine profile and routed prototype](/Users/sayat/.codex/worktrees/21f0/tinyML_accelerator/docs/research/PHASE_6_ENGINE_PROFILE_AND_PROTOTYPE_V1.md). Its purpose is to reject weak novelty hypotheses before a larger RTL campaign. The six screens below use different evidence levels; modeled traffic and service are never presented as device latency.

The strongest available *measured* KWS/VWW reference is generic B3 on the 27 MHz cached-weight co-issue image: **1,119,142 KWS and 2,157,255 VWW device cycles**, with exact short-screen outputs. That is a 6.889% geometric-mean latency reduction versus generic B3 on the predecessor image in separate protocol-matched sessions. The route uses 10,090/10,368 CLS and 38/46 BSRAM blocks. Those results belong to the completed task; this report does not repeat its board campaign or claim accuracy-set or energy qualification for that image.

| Screen | Completed result | Evidence level and decision |
| --- | --- | --- |
| [Operand delivery](../../work/phase6/parallel-operand-delivery-v1/summary.md) | Current one-word cache requests 270,336 KWS and 334,566 VWW pointwise words. Equal-bit two-word retention saves 0 and 2,922 words; ordinary two-output blocking cuts demand to 135,168 and 167,740 words. Adding two-word retention to that control saves just another 0 and 1,430 words. | The address model reproduces all observed first/cross reads and MAC issues in 20 frozen pointwise descriptors under two seeds. These are **traffic estimates**, not candidate RTL cycles. Loop blocking is the stronger baseline and likely an engineering optimization, not a novelty claim by itself. |
| [Resumable producer–consumer fusion](../../work/phase6/parallel-resumable-fusion-v1/README.md) | Exact quantized DW→PW replay passes 8,000 KWS and 36,864 early VWW outputs; PW→DW passes 18,432. Across 8–32 KiB, the best proposed continuation is **5.7–33.6% costlier** than ordinary output-stationary blocked fusion in a charged single-port service proxy. Early VWW loses 31.5% even when context switching is free. | Analytical service proxy, not a clock-accurate lower bound or routed timing. Existing exact VWW two-strip native control already has zero external bridge bytes and takes 280,897 versus 341,211 block cycles against non-fused execution on an older image. The proposed continuation does not pass the current investment gate. |
| [Compiler infeasibility bounds](../../work/phase6/parallel-infeasibility-bounds-v1/report.json) | Sound necessary bounds pre-reject **20,697/33,544** frozen B3 catalogue candidates (61.7%) with zero false rejections; all 2,133 executable command/SRAM certificates hold. Bounded cold slices improve 1.575→0.790 s KWS and 1.976→0.901 s VWW versus exact-halo memoization. | Source-pinned full-catalogue classification and one cold timing pass on 128/160 selected cases, respectively; **not** a full-search speedup or inference improvement. Useful compiler work, not architecture novelty. |
| [Held-out AD](../../work/phase6/parallel-ad-v1/README.md) | Full frozen calibration/evaluation gives INT8 recording ROC-AUC **0.884259** versus canonical float **0.880423**. The 19-layer graph lowers to 23 legal tiles and 259 commands; 32 real windows match the independent integer oracle at every layer. Two real windows pass 20 native RTL tensor checks each under fixed and stalled external RAM on both engines. | Full software quality and structural compilation; four paired native runs per engine. Baseline and co-issue candidate both take **295,640 fixed-RAM / 379,822 stalled-RAM cycles** on AD: no observed native gain. Board UART supplied no capability reply even after successful JTAG programming, so **no AD board timing or correctness claim**. |
| [Control-memory allocation](../../work/phase6/parallel-control-memory-v1/REPORT.md) | Byte-exact affine-loop expansion compresses frozen B3 code 1,744→1,224 B KWS and 15,568→6,032 B VWW. Both original streams already fit a fixed 16 KiB program tier; compressed and original streams each require eight modeled SP BSRAM blocks under the current eight-bank fetch organization. | Code/BRAM packing projection, validated by exact stream round-trip and adversarial decoder tests. A fixed 16 KiB program + 32 KiB data partition explains the projected eight-block saving relative to today's 32 KiB + 32 KiB memories **without loops or adaptive allocation**. No new RTL or route exists for the smaller partition. |
| [Lossless partial-sum widths](../../work/phase6/parallel-partial-sum-width-v1/REPORT.md) | Proven worst-case prefixes need over 16 bits in every KWS/VWW MAC channel, so ordinary 8/16/32-bit lanes save **no stored bytes** after metadata. Dense packing can shrink a hypothetical VWW 128×6×6 context from 18,432 to 13,832 B, but 1,027/4,608 contexts cross a 64-bit word; a separate same-style RAM is only *projected* to round from 16 to 8 blocks. | Exhaustive small-case proof and real-weight prefix checks; no RTL. A separate compressed RAM would consume the routed design's remaining eight BSRAM blocks (38→46/46), with added port transactions and no timing margin demonstrated. The current engine keeps accumulators in registers, so there is **no present physical gain**. |

## AD provenance and the memory incident

The AD experiment uses all **21,952 calibration windows** and all **48,608 disjoint evaluation windows** from the pinned ToyCar archive. A window is a five-frame, 640-feature inference; each of 248 recording scores averages 196 window reconstruction errors. The float result exactly reproduces the frozen source-quality score. The software VM image is 3,168,320 bytes because it embeds calibration provenance; its separate FPGA-lowering parameter image is 292,368 bytes. Native reports pin both executables to passed source/build reports. The candidate's KWS/VWW cache-hit gain does not transfer to this held-out dense graph under the same AD command stream.

The initial AD calibration process caused the reported >40 GB growth. In `compiler/static_cli.py`, `data[name][i]` was inside a 21,952-sample comprehension. Each access decompressed the **entire ~56 MB NPZ array**, and each row view retained that new backing array. [The fix](../../compiler/static_cli.py) loads each input member once and yields views; a [regression test](../../compiler/test_static_cli.py) checks shared storage. Full calibration now completes in about 10 seconds with **157.4 MiB measured peak RSS** and reproduces the same image hash. The CLI/static-pipeline test selection passes **59/59** tests.

## Research decision

The original review's leading thesis, *exact quantized fusion under a joint control, tensor-state, and memory-port budget*, has **not** survived its first strong controls on these models. A blocked quantized producer tile avoids the proposed continuation's INT32 read/write traffic, and the useful control-memory block saving is explained by a fixed partition. Narrow context storage is conditional on a context memory that the current engine does not have. None of the modeled savings should be added to the existing 27 MHz board medians.

The most concrete next hardware control is a **two-output activation-stationary pointwise loop order** implemented with the same eight MAC lanes, memory ports, and physical block budget, then checked and routed alongside the current co-issue image. This is a baseline strengthening step. A research contribution would need a mechanism that still wins after that control, fixed program/data partitioning, ordinary blocked fusion, and adapted published fusion schedules, including held-out AD and a residual graph. Report exact full-model correctness, routed frequency and area, matched board latency, and energy before claiming a top-tier architecture result. The current experiments provide a reproducible negative/conditional decision, not that result.

Reproduction scripts: [operand](../../tools/phase6/parallel_operand_delivery.py), [fusion](../../tools/phase6/parallel_resumable_fusion.py), [bounds](../../tools/phase6/parallel_infeasibility_bounds.py), [AD software](../../tools/phase6/parallel_ad_workload.py), [AD native](../../tools/phase6/parallel_ad_native.py), [control memory](../../tools/phase6/parallel_control_memory.py), [partial sums](../../tools/phase6/parallel_partial_sum_width.py). Each raw report retains source hashes and its own assumptions and limitations. An independent review found no material error in the initial operand, fusion, bounds, or AD screens and confirmed their evidence labels. All `work/` artifacts are local ignored files; the measurements above are retained in this repository report.
