SayatAbdikul/Ushqyn/docs/research/evidence/phase3-linebuffer/v2-test.txt

.venv/bin/python3 tools/phase2/generate_target.py --check
.venv/bin/python3 tools/phase2/lint.py
- V e r i l a t i o n   R e p o r t: Verilator 5.044 2026-01-01 rev vUNKNOWN-built20260101
- Verilator: Built from 0.378 MB sources in 10 modules, into 0.380 MB in 3 C++ files needing 0.000 MB
- Verilator: Walltime 0.086 s (elab=0.013, cvt=0.049, bld=0.000); cpu 0.074 s on 1 threads; alloced 19.031 MB
.venv/bin/python3 tools/phase2/prepare_mlp.py
{"used_bytes": 12416, "image_sha256": "c48e34857466d58b98a6b3ee6a284a06b3808a9e457799ba325b6b9186f0671b", "macs": 10112, "software_accuracy": 0.948}
.venv/bin/python3 test/phase2/run.py requantizer
/Users/sayat/Documents/GitHub/tinyML_accelerator/test/phase2/run.py:4: UserWarning: Python runners and associated APIs are an experimental feature and subject to change.
  from cocotb.runner import get_runner
- V e r i l a t i o n   R e p o r t: Verilator 5.044 2026-01-01 rev vUNKNOWN-built20260101
- Verilator: Built from 0.378 MB sources in 10 modules, into 0.055 MB in 8 C++ files needing 0.001 MB
- Verilator: Walltime 0.028 s (elab=0.003, cvt=0.008, bld=0.000); cpu 0.024 s on 1 threads; alloced 12.516 MB
c++  -I.  -MMD -I/opt/homebrew/Cellar/verilator/5.044/share/verilator/include -I/opt/homebrew/Cellar/verilator/5.044/share/verilator/include/vltstd -DVERILATOR=1 -DVM_COVERAGE=0 -DVM_SC=0 -DVM_TIMING=0 -DVM_TRACE=0 -DVM_TRACE_FST=0 -DVM_TRACE_VCD=0 -DVM_TRACE_SAIF=0 -faligned-new -fbracket-depth=4096 -fcf-protection=none -Xclang -fno-pch-timestamp -Qunused-arguments -Wno-bool-operation -Wno-c++11-narrowing -Wno-constant-logical-operand -Wno-int-in-bool-context -Wno-non-pod-varargs -Wno-parentheses-equality -Wno-shadow -Wno-sign-compare -Wno-tautological-bitwise-compare -Wno-tautological-compare -Wno-uninitialized -Wno-unused-but-set-parameter -Wno-unused-but-set-variable -Wno-unused-parameter -Wno-unused-variable     -std=gnu++17 -Os  -c -o verilator.o /Users/sayat/Documents/GitHub/tinyML_accelerator/.venv/lib/python3.13/site-packages/cocotb/share/lib/verilator/verilator.cpp
c++ -Os  -I.  -MMD -I/opt/homebrew/Cellar/verilator/5.044/share/verilator/include -I/opt/homebrew/Cellar/verilator/5.044/share/verilator/include/vltstd -DVERILATOR=1 -DVM_COVERAGE=0 -DVM_SC=0 -DVM_TIMING=0 -DVM_TRACE=0 -DVM_TRACE_FST=0 -DVM_TRACE_VCD=0 -DVM_TRACE_SAIF=0 -faligned-new -fbracket-depth=4096 -fcf-protection=none -Xclang -fno-pch-timestamp -Qunused-arguments -Wno-bool-operation -Wno-c++11-narrowing -Wno-constant-logical-operand -Wno-int-in-bool-context -Wno-non-pod-varargs -Wno-parentheses-equality -Wno-shadow -Wno-sign-compare -Wno-tautological-bitwise-compare -Wno-tautological-compare -Wno-uninitialized -Wno-unused-but-set-parameter -Wno-unused-but-set-variable -Wno-unused-parameter -Wno-unused-variable     -std=gnu++17 -c -o verilated.o /opt/homebrew/Cellar/verilator/5.044/share/verilator/include/verilated.cpp
c++ -Os  -I.  -MMD -I/opt/homebrew/Cellar/verilator/5.044/share/verilator/include -I/opt/homebrew/Cellar/verilator/5.044/share/verilator/include/vltstd -DVERILATOR=1 -DVM_COVERAGE=0 -DVM_SC=0 -DVM_TIMING=0 -DVM_TRACE=0 -DVM_TRACE_FST=0 -DVM_TRACE_VCD=0 -DVM_TRACE_SAIF=0 -faligned-new -fbracket-depth=4096 -fcf-protection=none -Xclang -fno-pch-timestamp -Qunused-arguments -Wno-bool-operation -Wno-c++11-narrowing -Wno-constant-logical-operand -Wno-int-in-bool-context -Wno-non-pod-varargs -Wno-parentheses-equality -Wno-shadow -Wno-sign-compare -Wno-tautological-bitwise-compare -Wno-tautological-compare -Wno-uninitialized -Wno-unused-but-set-parameter -Wno-unused-but-set-variable -Wno-unused-parameter -Wno-unused-variable     -std=gnu++17 -c -o verilated_dpi.o /opt/homebrew/Cellar/verilator/5.044/share/verilator/include/verilated_dpi.cpp
c++ -Os  -I.  -MMD -I/opt/homebrew/Cellar/verilator/5.044/share/verilator/include -I/opt/homebrew/Cellar/verilator/5.044/share/verilator/include/vltstd -DVERILATOR=1 -DVM_COVERAGE=0 -DVM_SC=0 -DVM_TIMING=0 -DVM_TRACE=0 -DVM_TRACE_FST=0 -DVM_TRACE_VCD=0 -DVM_TRACE_SAIF=0 -faligned-new -fbracket-depth=4096 -fcf-protection=none -Xclang -fno-pch-timestamp -Qunused-arguments -Wno-bool-operation -Wno-c++11-narrowing -Wno-constant-logical-operand -Wno-int-in-bool-context -Wno-non-pod-varargs -Wno-parentheses-equality -Wno-shadow -Wno-sign-compare -Wno-tautological-bitwise-compare -Wno-tautological-compare -Wno-uninitialized -Wno-unused-but-set-parameter -Wno-unused-but-set-variable -Wno-unused-parameter -Wno-unused-variable     -std=gnu++17 -c -o verilated_vpi.o /opt/homebrew/Cellar/verilator/5.044/share/verilator/include/verilated_vpi.cpp
c++ -Os  -I.  -MMD -I/opt/homebrew/Cellar/verilator/5.044/share/verilator/include -I/opt/homebrew/Cellar/verilator/5.044/share/verilator/include/vltstd -DVERILATOR=1 -DVM_COVERAGE=0 -DVM_SC=0 -DVM_TIMING=0 -DVM_TRACE=0 -DVM_TRACE_FST=0 -DVM_TRACE_VCD=0 -DVM_TRACE_SAIF=0 -faligned-new -fbracket-depth=4096 -fcf-protection=none -Xclang -fno-pch-timestamp -Qunused-arguments -Wno-bool-operation -Wno-c++11-narrowing -Wno-constant-logical-operand -Wno-int-in-bool-context -Wno-non-pod-varargs -Wno-parentheses-equality -Wno-shadow -Wno-sign-compare -Wno-tautological-bitwise-compare -Wno-tautological-compare -Wno-uninitialized -Wno-unused-but-set-parameter -Wno-unused-but-set-variable -Wno-unused-parameter -Wno-unused-variable     -std=gnu++17 -c -o verilated_threads.o /opt/homebrew/Cellar/verilator/5.044/share/verilator/include/verilated_threads.cpp
python3 /opt/homebrew/Cellar/verilator/5.044/share/verilator/bin/verilator_includer -DVL_INCLUDE_OPT=include Vtop.cpp Vtop___024root__0.cpp Vtop__Dpi.cpp Vtop___024root__Slow.cpp Vtop___024root__0__Slow.cpp Vtop_target_pkg__Slow.cpp Vtop_target_pkg__0__Slow.cpp Vtop__Syms__Slow.cpp > Vtop__ALL.cpp
c++ -Os  -I.  -MMD -I/opt/homebrew/Cellar/verilator/5.044/share/verilator/include -I/opt/homebrew/Cellar/verilator/5.044/share/verilator/include/vltstd -DVERILATOR=1 -DVM_COVERAGE=0 -DVM_SC=0 -DVM_TIMING=0 -DVM_TRACE=0 -DVM_TRACE_FST=0 -DVM_TRACE_VCD=0 -DVM_TRACE_SAIF=0 -faligned-new -fbracket-depth=4096 -fcf-protection=none -Xclang -fno-pch-timestamp -Qunused-arguments -Wno-bool-operation -Wno-c++11-narrowing -Wno-constant-logical-operand -Wno-int-in-bool-context -Wno-non-pod-varargs -Wno-parentheses-equality -Wno-shadow -Wno-sign-compare -Wno-tautological-bitwise-compare -Wno-tautological-compare -Wno-uninitialized -Wno-unused-but-set-parameter -Wno-unused-but-set-variable -Wno-unused-parameter -Wno-unused-variable     -std=gnu++17 -c -o Vtop__ALL.o Vtop__ALL.cpp
c++  -Wl,-U,__Z15vl_time_stamp64v,-U,__Z13sc_time_stampv   verilator.o verilated.o verilated_dpi.o verilated_vpi.o verilated_threads.o Vtop__ALL.a   -Wl,-rpath,/Users/sayat/Documents/GitHub/tinyML_accelerator/.venv/lib/python3.13/site-packages/cocotb/libs -L/Users/sayat/Documents/GitHub/tinyML_accelerator/.venv/lib/python3.13/site-packages/cocotb/libs -lcocotbvpi_verilator  -pthread -lpthread   -o v2_requantizer
rm Vtop__ALL.verilator_deplist.tmp
     -.--ns INFO     gpi                                ..mbed/gpi_embed.cpp:81   in set_program_name_in_venv        Did not detect Python virtual environment. Using system-wide Python interpreter
     -.--ns INFO     gpi                                ../gpi/GpiCommon.cpp:101  in gpi_print_registered_impl       VPI registered
     0.00ns INFO     cocotb                             Running on Verilator version 5.044 2026-01-01
     0.00ns INFO     cocotb                             Running tests with cocotb v1.9.2 from /Users/sayat/Documents/GitHub/tinyML_accelerator/.venv/lib/python3.13/site-packages/cocotb
     0.00ns INFO     cocotb                             Seeding Python random module with 1790180327
     0.00ns INFO     cocotb.regression                  Found test test_requantizer.rounding_stalls_flush
     0.00ns INFO     cocotb.regression                  running rounding_stalls_flush (1/1)
 28980.00ns INFO     cocotb.regression                  rounding_stalls_flush passed
 28980.00ns INFO     cocotb.regression                  ************************************************************************************************
                                                        ** TEST                                    STATUS  SIM TIME (ns)  REAL TIME (s)  RATIO (ns/s) **
                                                        ************************************************************************************************
                                                        ** test_requantizer.rounding_stalls_flush   PASS       28980.00           0.18     163615.06  **
                                                        ************************************************************************************************
                                                        ** TESTS=1 PASS=1 FAIL=0 SKIP=0                        28980.00           0.20     142812.08  **
                                                        ************************************************************************************************
                                                        
- :0: Verilog $finish
INFO: Running command perl /opt/homebrew/bin/verilator -cc --exe -Mdir /Users/sayat/Documents/GitHub/tinyML_accelerator/work/phase2/sim_requantizer -DCOCOTB_SIM=1 --top-module v2_requantizer --vpi --public-flat-rw --prefix Vtop -o v2_requantizer -LDFLAGS '-Wl,-rpath,/Users/sayat/Documents/GitHub/tinyML_accelerator/.venv/lib/python3.13/site-packages/cocotb/libs -L/Users/sayat/Documents/GitHub/tinyML_accelerator/.venv/lib/python3.13/site-packages/cocotb/libs -lcocotbvpi_verilator' --timing -Wno-fatal /Users/sayat/Documents/GitHub/tinyML_accelerator/.venv/lib/python3.13/site-packages/cocotb/share/lib/verilator/verilator.cpp /Users/sayat/Documents/GitHub/tinyML_accelerator/rtl/v2/target_pkg.sv /Users/sayat/Documents/GitHub/tinyML_accelerator/rtl/v2/requantizer.sv /Users/sayat/Documents/GitHub/tinyML_accelerator/rtl/v2/scratchpad.sv /Users/sayat/Documents/GitHub/tinyML_accelerator/rtl/v2/engine.sv /Users/sayat/Documents/GitHub/tinyML_accelerator/rtl/v2/command.sv /Users/sayat/Documents/GitHub/tinyML_accelerator/rtl/v2/system.sv /Users/sayat/Documents/GitHub/tinyML_accelerator/rtl/v2/uart_rx.sv /Users/sayat/Documents/GitHub/tinyML_accelerator/rtl/v2/uart_tx.sv /Users/sayat/Documents/GitHub/tinyML_accelerator/hardware/tang_nano_v2.sv in directory /Users/sayat/Documents/GitHub/tinyML_accelerator/work/phase2/sim_requantizer
INFO: Running command make -C /Users/sayat/Documents/GitHub/tinyML_accelerator/work/phase2/sim_requantizer -f Vtop.mk VM_TRACE=0 in directory /Users/sayat/Documents/GitHub/tinyML_accelerator/work/phase2/sim_requantizer
INFO: Running command /Users/sayat/Documents/GitHub/tinyML_accelerator/work/phase2/sim_requantizer/v2_requantizer in directory /Users/sayat/Documents/GitHub/tinyML_accelerator/test/phase2
INFO: Results file: /Users/sayat/Documents/GitHub/tinyML_accelerator/work/phase2/sim_requantizer/results.xml
.venv/bin/python3 test/phase2/run.py engine
/Users/sayat/Documents/GitHub/tinyML_accelerator/test/phase2/run.py:4: UserWarning: Python runners and associated APIs are an experimental feature and subject to change.
  from cocotb.runner import get_runner
- V e r i l a t i o n   R e p o r t: Verilator 5.044 2026-01-01 rev vUNKNOWN-built20260101
- Verilator: Built from 0.378 MB sources in 10 modules, into 0.309 MB in 8 C++ files needing 0.001 MB
- Verilator: Walltime 0.061 s (elab=0.006, cvt=0.035, bld=0.000); cpu 0.059 s on 1 threads; alloced 17.125 MB
c++  -I.  -MMD -I/opt/homebrew/Cellar/verilator/5.044/share/verilator/include -I/opt/homebrew/Cellar/verilator/5.044/share/verilator/include/vltstd -DVERILATOR=1 -DVM_COVERAGE=0 -DVM_SC=0 -DVM_TIMING=0 -DVM_TRACE=0 -DVM_TRACE_FST=0 -DVM_TRACE_VCD=0 -DVM_TRACE_SAIF=0 -faligned-new -fbracket-depth=4096 -fcf-protection=none -Xclang -fno-pch-timestamp -Qunused-arguments -Wno-bool-operation -Wno-c++11-narrowing -Wno-constant-logical-operand -Wno-int-in-bool-context -Wno-non-pod-varargs -Wno-parentheses-equality -Wno-shadow -Wno-sign-compare -Wno-tautological-bitwise-compare -Wno-tautological-compare -Wno-uninitialized -Wno-unused-but-set-parameter -Wno-unused-but-set-variable -Wno-unused-parameter -Wno-unused-variable     -std=gnu++17 -Os  -c -o verilator.o /Users/sayat/Documents/GitHub/tinyML_accelerator/.venv/lib/python3.13/site-packages/cocotb/share/lib/verilator/verilator.cpp
c++ -Os  -I.  -MMD -I/opt/homebrew/Cellar/verilator/5.044/share/verilator/include -I/opt/homebrew/Cellar/verilator/5.044/share/verilator/include/vltstd -DVERILATOR=1 -DVM_COVERAGE=0 -DVM_SC=0 -DVM_TIMING=0 -DVM_TRACE=0 -DVM_TRACE_FST=0 -DVM_TRACE_VCD=0 -DVM_TRACE_SAIF=0 -faligned-new -fbracket-depth=4096 -fcf-protection=none -Xclang -fno-pch-timestamp -Qunused-arguments -Wno-bool-operation -Wno-c++11-narrowing -Wno-constant-logical-operand -Wno-int-in-bool-context -Wno-non-pod-varargs -Wno-parentheses-equality -Wno-shadow -Wno-sign-compare -Wno-tautological-bitwise-compare -Wno-tautological-compare -Wno-uninitialized -Wno-unused-but-set-parameter -Wno-unused-but-set-variable -Wno-unused-parameter -Wno-unused-variable     -std=gnu++17 -c -o verilated.o /opt/homebrew/Cellar/verilator/5.044/share/verilator/include/verilated.cpp
c++ -Os  -I.  -MMD -I/opt/homebrew/Cellar/verilator/5.044/share/verilator/include -I/opt/homebrew/Cellar/verilator/5.044/share/verilator/include/vltstd -DVERILATOR=1 -DVM_COVERAGE=0 -DVM_SC=0 -DVM_TIMING=0 -DVM_TRACE=0 -DVM_TRACE_FST=0 -DVM_TRACE_VCD=0 -DVM_TRACE_SAIF=0 -faligned-new -fbracket-depth=4096 -fcf-protection=none -Xclang -fno-pch-timestamp -Qunused-arguments -Wno-bool-operation -Wno-c++11-narrowing -Wno-constant-logical-operand -Wno-int-in-bool-context -Wno-non-pod-varargs -Wno-parentheses-equality -Wno-shadow -Wno-sign-compare -Wno-tautological-bitwise-compare -Wno-tautological-compare -Wno-uninitialized -Wno-unused-but-set-parameter -Wno-unused-but-set-variable -Wno-unused-parameter -Wno-unused-variable     -std=gnu++17 -c -o verilated_dpi.o /opt/homebrew/Cellar/verilator/5.044/share/verilator/include/verilated_dpi.cpp
c++ -Os  -I.  -MMD -I/opt/homebrew/Cellar/verilator/5.044/share/verilator/include -I/opt/homebrew/Cellar/verilator/5.044/share/verilator/include/vltstd -DVERILATOR=1 -DVM_COVERAGE=0 -DVM_SC=0 -DVM_TIMING=0 -DVM_TRACE=0 -DVM_TRACE_FST=0 -DVM_TRACE_VCD=0 -DVM_TRACE_SAIF=0 -faligned-new -fbracket-depth=4096 -fcf-protection=none -Xclang -fno-pch-timestamp -Qunused-arguments -Wno-bool-operation -Wno-c++11-narrowing -Wno-constant-logical-operand -Wno-int-in-bool-context -Wno-non-pod-varargs -Wno-parentheses-equality -Wno-shadow -Wno-sign-compare -Wno-tautological-bitwise-compare -Wno-tautological-compare -Wno-uninitialized -Wno-unused-but-set-parameter -Wno-unused-but-set-variable -Wno-unused-parameter -Wno-unused-variable     -std=gnu++17 -c -o verilated_vpi.o /opt/homebrew/Cellar/verilator/5.044/share/verilator/include/verilated_vpi.cpp
c++ -Os  -I.  -MMD -I/opt/homebrew/Cellar/verilator/5.044/share/verilator/include -I/opt/homebrew/Cellar/verilator/5.044/share/verilator/include/vltstd -DVERILATOR=1 -DVM_COVERAGE=0 -DVM_SC=0 -DVM_TIMING=0 -DVM_TRACE=0 -DVM_TRACE_FST=0 -DVM_TRACE_VCD=0 -DVM_TRACE_SAIF=0 -faligned-new -fbracket-depth=4096 -fcf-protection=none -Xclang -fno-pch-timestamp -Qunused-arguments -Wno-bool-operation -Wno-c++11-narrowing -Wno-constant-logical-operand -Wno-int-in-bool-context -Wno-non-pod-varargs -Wno-parentheses-equality -Wno-shadow -Wno-sign-compare -Wno-tautological-bitwise-compare -Wno-tautological-compare -Wno-uninitialized -Wno-unused-but-set-parameter -Wno-unused-but-set-variable -Wno-unused-parameter -Wno-unused-variable     -std=gnu++17 -c -o verilated_threads.o /opt/homebrew/Cellar/verilator/5.044/share/verilator/include/verilated_threads.cpp
python3 /opt/homebrew/Cellar/verilator/5.044/share/verilator/bin/verilator_includer -DVL_INCLUDE_OPT=include Vtop.cpp Vtop___024root__0.cpp Vtop__Dpi.cpp Vtop___024root__Slow.cpp Vtop___024root__0__Slow.cpp Vtop_target_pkg__Slow.cpp Vtop_target_pkg__0__Slow.cpp Vtop__Syms__Slow.cpp > Vtop__ALL.cpp
c++ -Os  -I.  -MMD -I/opt/homebrew/Cellar/verilator/5.044/share/verilator/include -I/opt/homebrew/Cellar/verilator/5.044/share/verilator/include/vltstd -DVERILATOR=1 -DVM_COVERAGE=0 -DVM_SC=0 -DVM_TIMING=0 -DVM_TRACE=0 -DVM_TRACE_FST=0 -DVM_TRACE_VCD=0 -DVM_TRACE_SAIF=0 -faligned-new -fbracket-depth=4096 -fcf-protection=none -Xclang -fno-pch-timestamp -Qunused-arguments -Wno-bool-operation -Wno-c++11-narrowing -Wno-constant-logical-operand -Wno-int-in-bool-context -Wno-non-pod-varargs -Wno-parentheses-equality -Wno-shadow -Wno-sign-compare -Wno-tautological-bitwise-compare -Wno-tautological-compare -Wno-uninitialized -Wno-unused-but-set-parameter -Wno-unused-but-set-variable -Wno-unused-parameter -Wno-unused-variable     -std=gnu++17 -c -o Vtop__ALL.o Vtop__ALL.cpp
c++  -Wl,-U,__Z15vl_time_stamp64v,-U,__Z13sc_time_stampv   verilator.o verilated.o verilated_dpi.o verilated_vpi.o verilated_threads.o Vtop__ALL.a   -Wl,-rpath,/Users/sayat/Documents/GitHub/tinyML_accelerator/.venv/lib/python3.13/site-packages/cocotb/libs -L/Users/sayat/Documents/GitHub/tinyML_accelerator/.venv/lib/python3.13/site-packages/cocotb/libs -lcocotbvpi_verilator  -pthread -lpthread   -o v2_engine
rm Vtop__ALL.verilator_deplist.tmp
     -.--ns INFO     gpi                                ..mbed/gpi_embed.cpp:81   in set_program_name_in_venv        Did not detect Python virtual environment. Using system-wide Python interpreter
     -.--ns INFO     gpi                                ../gpi/GpiCommon.cpp:101  in gpi_print_registered_impl       VPI registered
     0.00ns INFO     cocotb                             Running on Verilator version 5.044 2026-01-01
     0.00ns INFO     cocotb                             Running tests with cocotb v1.9.2 from /Users/sayat/Documents/GitHub/tinyML_accelerator/.venv/lib/python3.13/site-packages/cocotb
     0.00ns INFO     cocotb                             Seeding Python random module with 1790180339
     0.00ns INFO     cocotb.regression                  Found test test_engine.randomized_memory_latency_and_abort
     0.00ns INFO     cocotb.regression                  running randomized_memory_latency_and_abort (1/1)
178430.00ns INFO     cocotb.regression                  randomized_memory_latency_and_abort passed
178430.00ns INFO     cocotb.regression                  *********************************************************************************************************
                                                        ** TEST                                             STATUS  SIM TIME (ns)  REAL TIME (s)  RATIO (ns/s) **
                                                        *********************************************************************************************************
                                                        ** test_engine.randomized_memory_latency_and_abort   PASS      178430.00           1.41     126168.86  **
                                                        *********************************************************************************************************
                                                        ** TESTS=1 PASS=1 FAIL=0 SKIP=0                                178430.00           1.76     101228.96  **
                                                        *********************************************************************************************************
                                                        
- :0: Verilog $finish
INFO: Running command perl /opt/homebrew/bin/verilator -cc --exe -Mdir /Users/sayat/Documents/GitHub/tinyML_accelerator/work/phase2/sim_engine -DCOCOTB_SIM=1 --top-module v2_engine --vpi --public-flat-rw --prefix Vtop -o v2_engine -LDFLAGS '-Wl,-rpath,/Users/sayat/Documents/GitHub/tinyML_accelerator/.venv/lib/python3.13/site-packages/cocotb/libs -L/Users/sayat/Documents/GitHub/tinyML_accelerator/.venv/lib/python3.13/site-packages/cocotb/libs -lcocotbvpi_verilator' --timing -Wno-fatal /Users/sayat/Documents/GitHub/tinyML_accelerator/.venv/lib/python3.13/site-packages/cocotb/share/lib/verilator/verilator.cpp /Users/sayat/Documents/GitHub/tinyML_accelerator/rtl/v2/target_pkg.sv /Users/sayat/Documents/GitHub/tinyML_accelerator/rtl/v2/requantizer.sv /Users/sayat/Documents/GitHub/tinyML_accelerator/rtl/v2/scratchpad.sv /Users/sayat/Documents/GitHub/tinyML_accelerator/rtl/v2/engine.sv /Users/sayat/Documents/GitHub/tinyML_accelerator/rtl/v2/command.sv /Users/sayat/Documents/GitHub/tinyML_accelerator/rtl/v2/system.sv /Users/sayat/Documents/GitHub/tinyML_accelerator/rtl/v2/uart_rx.sv /Users/sayat/Documents/GitHub/tinyML_accelerator/rtl/v2/uart_tx.sv /Users/sayat/Documents/GitHub/tinyML_accelerator/hardware/tang_nano_v2.sv in directory /Users/sayat/Documents/GitHub/tinyML_accelerator/work/phase2/sim_engine
INFO: Running command make -C /Users/sayat/Documents/GitHub/tinyML_accelerator/work/phase2/sim_engine -f Vtop.mk VM_TRACE=0 in directory /Users/sayat/Documents/GitHub/tinyML_accelerator/work/phase2/sim_engine
INFO: Running command /Users/sayat/Documents/GitHub/tinyML_accelerator/work/phase2/sim_engine/v2_engine in directory /Users/sayat/Documents/GitHub/tinyML_accelerator/test/phase2
INFO: Results file: /Users/sayat/Documents/GitHub/tinyML_accelerator/work/phase2/sim_engine/results.xml
.venv/bin/python3 test/phase2/run.py board
/Users/sayat/Documents/GitHub/tinyML_accelerator/test/phase2/run.py:4: UserWarning: Python runners and associated APIs are an experimental feature and subject to change.
  from cocotb.runner import get_runner
- V e r i l a t i o n   R e p o r t: Verilator 5.044 2026-01-01 rev vUNKNOWN-built20260101
- Verilator: Built from 0.378 MB sources in 10 modules, into 0.634 MB in 8 C++ files needing 0.001 MB
- Verilator: Walltime 0.215 s (elab=0.024, cvt=0.129, bld=0.000); cpu 0.169 s on 1 threads; alloced 19.641 MB
c++  -I.  -MMD -I/opt/homebrew/Cellar/verilator/5.044/share/verilator/include -I/opt/homebrew/Cellar/verilator/5.044/share/verilator/include/vltstd -DVERILATOR=1 -DVM_COVERAGE=0 -DVM_SC=0 -DVM_TIMING=0 -DVM_TRACE=0 -DVM_TRACE_FST=0 -DVM_TRACE_VCD=0 -DVM_TRACE_SAIF=0 -faligned-new -fbracket-depth=4096 -fcf-protection=none -Xclang -fno-pch-timestamp -Qunused-arguments -Wno-bool-operation -Wno-c++11-narrowing -Wno-constant-logical-operand -Wno-int-in-bool-context -Wno-non-pod-varargs -Wno-parentheses-equality -Wno-shadow -Wno-sign-compare -Wno-tautological-bitwise-compare -Wno-tautological-compare -Wno-uninitialized -Wno-unused-but-set-parameter -Wno-unused-but-set-variable -Wno-unused-parameter -Wno-unused-variable     -std=gnu++17 -Os  -c -o verilator.o /Users/sayat/Documents/GitHub/tinyML_accelerator/.venv/lib/python3.13/site-packages/cocotb/share/lib/verilator/verilator.cpp
c++ -Os  -I.  -MMD -I/opt/homebrew/Cellar/verilator/5.044/share/verilator/include -I/opt/homebrew/Cellar/verilator/5.044/share/verilator/include/vltstd -DVERILATOR=1 -DVM_COVERAGE=0 -DVM_SC=0 -DVM_TIMING=0 -DVM_TRACE=0 -DVM_TRACE_FST=0 -DVM_TRACE_VCD=0 -DVM_TRACE_SAIF=0 -faligned-new -fbracket-depth=4096 -fcf-protection=none -Xclang -fno-pch-timestamp -Qunused-arguments -Wno-bool-operation -Wno-c++11-narrowing -Wno-constant-logical-operand -Wno-int-in-bool-context -Wno-non-pod-varargs -Wno-parentheses-equality -Wno-shadow -Wno-sign-compare -Wno-tautological-bitwise-compare -Wno-tautological-compare -Wno-uninitialized -Wno-unused-but-set-parameter -Wno-unused-but-set-variable -Wno-unused-parameter -Wno-unused-variable     -std=gnu++17 -c -o verilated.o /opt/homebrew/Cellar/verilator/5.044/share/verilator/include/verilated.cpp
c++ -Os  -I.  -MMD -I/opt/homebrew/Cellar/verilator/5.044/share/verilator/include -I/opt/homebrew/Cellar/verilator/5.044/share/verilator/include/vltstd -DVERILATOR=1 -DVM_COVERAGE=0 -DVM_SC=0 -DVM_TIMING=0 -DVM_TRACE=0 -DVM_TRACE_FST=0 -DVM_TRACE_VCD=0 -DVM_TRACE_SAIF=0 -faligned-new -fbracket-depth=4096 -fcf-protection=none -Xclang -fno-pch-timestamp -Qunused-arguments -Wno-bool-operation -Wno-c++11-narrowing -Wno-constant-logical-operand -Wno-int-in-bool-context -Wno-non-pod-varargs -Wno-parentheses-equality -Wno-shadow -Wno-sign-compare -Wno-tautological-bitwise-compare -Wno-tautological-compare -Wno-uninitialized -Wno-unused-but-set-parameter -Wno-unused-but-set-variable -Wno-unused-parameter -Wno-unused-variable     -std=gnu++17 -c -o verilated_dpi.o /opt/homebrew/Cellar/verilator/5.044/share/verilator/include/verilated_dpi.cpp
c++ -Os  -I.  -MMD -I/opt/homebrew/Cellar/verilator/5.044/share/verilator/include -I/opt/homebrew/Cellar/verilator/5.044/share/verilator/include/vltstd -DVERILATOR=1 -DVM_COVERAGE=0 -DVM_SC=0 -DVM_TIMING=0 -DVM_TRACE=0 -DVM_TRACE_FST=0 -DVM_TRACE_VCD=0 -DVM_TRACE_SAIF=0 -faligned-new -fbracket-depth=4096 -fcf-protection=none -Xclang -fno-pch-timestamp -Qunused-arguments -Wno-bool-operation -Wno-c++11-narrowing -Wno-constant-logical-operand -Wno-int-in-bool-context -Wno-non-pod-varargs -Wno-parentheses-equality -Wno-shadow -Wno-sign-compare -Wno-tautological-bitwise-compare -Wno-tautological-compare -Wno-uninitialized -Wno-unused-but-set-parameter -Wno-unused-but-set-variable -Wno-unused-parameter -Wno-unused-variable     -std=gnu++17 -c -o verilated_vpi.o /opt/homebrew/Cellar/verilator/5.044/share/verilator/include/verilated_vpi.cpp
c++ -Os  -I.  -MMD -I/opt/homebrew/Cellar/verilator/5.044/share/verilator/include -I/opt/homebrew/Cellar/verilator/5.044/share/verilator/include/vltstd -DVERILATOR=1 -DVM_COVERAGE=0 -DVM_SC=0 -DVM_TIMING=0 -DVM_TRACE=0 -DVM_TRACE_FST=0 -DVM_TRACE_VCD=0 -DVM_TRACE_SAIF=0 -faligned-new -fbracket-depth=4096 -fcf-protection=none -Xclang -fno-pch-timestamp -Qunused-arguments -Wno-bool-operation -Wno-c++11-narrowing -Wno-constant-logical-operand -Wno-int-in-bool-context -Wno-non-pod-varargs -Wno-parentheses-equality -Wno-shadow -Wno-sign-compare -Wno-tautological-bitwise-compare -Wno-tautological-compare -Wno-uninitialized -Wno-unused-but-set-parameter -Wno-unused-but-set-variable -Wno-unused-parameter -Wno-unused-variable     -std=gnu++17 -c -o verilated_threads.o /opt/homebrew/Cellar/verilator/5.044/share/verilator/include/verilated_threads.cpp
python3 /opt/homebrew/Cellar/verilator/5.044/share/verilator/bin/verilator_includer -DVL_INCLUDE_OPT=include Vtop.cpp Vtop___024root__0.cpp Vtop__Dpi.cpp Vtop___024root__Slow.cpp Vtop___024root__0__Slow.cpp Vtop_target_pkg__Slow.cpp Vtop_target_pkg__0__Slow.cpp Vtop__Syms__Slow.cpp > Vtop__ALL.cpp
c++ -Os  -I.  -MMD -I/opt/homebrew/Cellar/verilator/5.044/share/verilator/include -I/opt/homebrew/Cellar/verilator/5.044/share/verilator/include/vltstd -DVERILATOR=1 -DVM_COVERAGE=0 -DVM_SC=0 -DVM_TIMING=0 -DVM_TRACE=0 -DVM_TRACE_FST=0 -DVM_TRACE_VCD=0 -DVM_TRACE_SAIF=0 -faligned-new -fbracket-depth=4096 -fcf-protection=none -Xclang -fno-pch-timestamp -Qunused-arguments -Wno-bool-operation -Wno-c++11-narrowing -Wno-constant-logical-operand -Wno-int-in-bool-context -Wno-non-pod-varargs -Wno-parentheses-equality -Wno-shadow -Wno-sign-compare -Wno-tautological-bitwise-compare -Wno-tautological-compare -Wno-uninitialized -Wno-unused-but-set-parameter -Wno-unused-but-set-variable -Wno-unused-parameter -Wno-unused-variable     -std=gnu++17 -c -o Vtop__ALL.o Vtop__ALL.cpp
c++  -Wl,-U,__Z15vl_time_stamp64v,-U,__Z13sc_time_stampv   verilator.o verilated.o verilated_dpi.o verilated_vpi.o verilated_threads.o Vtop__ALL.a   -Wl,-rpath,/Users/sayat/Documents/GitHub/tinyML_accelerator/.venv/lib/python3.13/site-packages/cocotb/libs -L/Users/sayat/Documents/GitHub/tinyML_accelerator/.venv/lib/python3.13/site-packages/cocotb/libs -lcocotbvpi_verilator  -pthread -lpthread   -o tang_nano_v2
rm Vtop__ALL.verilator_deplist.tmp
     -.--ns INFO     gpi                                ..mbed/gpi_embed.cpp:81   in set_program_name_in_venv        Did not detect Python virtual environment. Using system-wide Python interpreter
     -.--ns INFO     gpi                                ../gpi/GpiCommon.cpp:101  in gpi_print_registered_impl       VPI registered
     0.00ns INFO     cocotb                             Running on Verilator version 5.044 2026-01-01
     0.00ns INFO     cocotb                             Running tests with cocotb v1.9.2 from /Users/sayat/Documents/GitHub/tinyML_accelerator/.venv/lib/python3.13/site-packages/cocotb
     0.00ns INFO     cocotb                             Seeding Python random module with 1790180354
     0.00ns INFO     cocotb.regression                  Found test test_board.serial_board_top
     0.00ns INFO     cocotb.regression                  running serial_board_top (1/1)
342110.00ns INFO     cocotb.regression                  serial_board_top passed
342110.00ns INFO     cocotb.regression                  **************************************************************************************
                                                        ** TEST                          STATUS  SIM TIME (ns)  REAL TIME (s)  RATIO (ns/s) **
                                                        **************************************************************************************
                                                        ** test_board.serial_board_top    PASS      342110.00           1.88     182029.44  **
                                                        **************************************************************************************
                                                        ** TESTS=1 PASS=1 FAIL=0 SKIP=0             342110.00           3.01     113588.75  **
                                                        **************************************************************************************
                                                        
- :0: Verilog $finish
INFO: Running command perl /opt/homebrew/bin/verilator -cc --exe -Mdir /Users/sayat/Documents/GitHub/tinyML_accelerator/work/phase2/sim_board -DCOCOTB_SIM=1 --top-module tang_nano_v2 --vpi --public-flat-rw --prefix Vtop -o tang_nano_v2 -LDFLAGS '-Wl,-rpath,/Users/sayat/Documents/GitHub/tinyML_accelerator/.venv/lib/python3.13/site-packages/cocotb/libs -L/Users/sayat/Documents/GitHub/tinyML_accelerator/.venv/lib/python3.13/site-packages/cocotb/libs -lcocotbvpi_verilator' --timing -Wno-fatal -GCLOCK_HZ=100 -GBAUD=10 /Users/sayat/Documents/GitHub/tinyML_accelerator/.venv/lib/python3.13/site-packages/cocotb/share/lib/verilator/verilator.cpp /Users/sayat/Documents/GitHub/tinyML_accelerator/rtl/v2/target_pkg.sv /Users/sayat/Documents/GitHub/tinyML_accelerator/rtl/v2/requantizer.sv /Users/sayat/Documents/GitHub/tinyML_accelerator/rtl/v2/scratchpad.sv /Users/sayat/Documents/GitHub/tinyML_accelerator/rtl/v2/engine.sv /Users/sayat/Documents/GitHub/tinyML_accelerator/rtl/v2/command.sv /Users/sayat/Documents/GitHub/tinyML_accelerator/rtl/v2/system.sv /Users/sayat/Documents/GitHub/tinyML_accelerator/rtl/v2/uart_rx.sv /Users/sayat/Documents/GitHub/tinyML_accelerator/rtl/v2/uart_tx.sv /Users/sayat/Documents/GitHub/tinyML_accelerator/hardware/tang_nano_v2.sv in directory /Users/sayat/Documents/GitHub/tinyML_accelerator/work/phase2/sim_board
INFO: Running command make -C /Users/sayat/Documents/GitHub/tinyML_accelerator/work/phase2/sim_board -f Vtop.mk VM_TRACE=0 in directory /Users/sayat/Documents/GitHub/tinyML_accelerator/work/phase2/sim_board
INFO: Running command /Users/sayat/Documents/GitHub/tinyML_accelerator/work/phase2/sim_board/tang_nano_v2 in directory /Users/sayat/Documents/GitHub/tinyML_accelerator/test/phase2
INFO: Results file: /Users/sayat/Documents/GitHub/tinyML_accelerator/work/phase2/sim_board/results.xml
.venv/bin/python3 test/phase2/run.py system
/Users/sayat/Documents/GitHub/tinyML_accelerator/test/phase2/run.py:4: UserWarning: Python runners and associated APIs are an experimental feature and subject to change.
  from cocotb.runner import get_runner
- V e r i l a t i o n   R e p o r t: Verilator 5.044 2026-01-01 rev vUNKNOWN-built20260101
- Verilator: Built from 0.378 MB sources in 10 modules, into 0.505 MB in 8 C++ files needing 0.001 MB
- Verilator: Walltime 0.098 s (elab=0.011, cvt=0.060, bld=0.000); cpu 0.084 s on 1 threads; alloced 19.250 MB
c++  -I.  -MMD -I/opt/homebrew/Cellar/verilator/5.044/share/verilator/include -I/opt/homebrew/Cellar/verilator/5.044/share/verilator/include/vltstd -DVERILATOR=1 -DVM_COVERAGE=0 -DVM_SC=0 -DVM_TIMING=0 -DVM_TRACE=0 -DVM_TRACE_FST=0 -DVM_TRACE_VCD=0 -DVM_TRACE_SAIF=0 -faligned-new -fbracket-depth=4096 -fcf-protection=none -Xclang -fno-pch-timestamp -Qunused-arguments -Wno-bool-operation -Wno-c++11-narrowing -Wno-constant-logical-operand -Wno-int-in-bool-context -Wno-non-pod-varargs -Wno-parentheses-equality -Wno-shadow -Wno-sign-compare -Wno-tautological-bitwise-compare -Wno-tautological-compare -Wno-uninitialized -Wno-unused-but-set-parameter -Wno-unused-but-set-variable -Wno-unused-parameter -Wno-unused-variable     -std=gnu++17 -Os  -c -o verilator.o /Users/sayat/Documents/GitHub/tinyML_accelerator/.venv/lib/python3.13/site-packages/cocotb/share/lib/verilator/verilator.cpp
c++ -Os  -I.  -MMD -I/opt/homebrew/Cellar/verilator/5.044/share/verilator/include -I/opt/homebrew/Cellar/verilator/5.044/share/verilator/include/vltstd -DVERILATOR=1 -DVM_COVERAGE=0 -DVM_SC=0 -DVM_TIMING=0 -DVM_TRACE=0 -DVM_TRACE_FST=0 -DVM_TRACE_VCD=0 -DVM_TRACE_SAIF=0 -faligned-new -fbracket-depth=4096 -fcf-protection=none -Xclang -fno-pch-timestamp -Qunused-arguments -Wno-bool-operation -Wno-c++11-narrowing -Wno-constant-logical-operand -Wno-int-in-bool-context -Wno-non-pod-varargs -Wno-parentheses-equality -Wno-shadow -Wno-sign-compare -Wno-tautological-bitwise-compare -Wno-tautological-compare -Wno-uninitialized -Wno-unused-but-set-parameter -Wno-unused-but-set-variable -Wno-unused-parameter -Wno-unused-variable     -std=gnu++17 -c -o verilated.o /opt/homebrew/Cellar/verilator/5.044/share/verilator/include/verilated.cpp
c++ -Os  -I.  -MMD -I/opt/homebrew/Cellar/verilator/5.044/share/verilator/include -I/opt/homebrew/Cellar/verilator/5.044/share/verilator/include/vltstd -DVERILATOR=1 -DVM_COVERAGE=0 -DVM_SC=0 -DVM_TIMING=0 -DVM_TRACE=0 -DVM_TRACE_FST=0 -DVM_TRACE_VCD=0 -DVM_TRACE_SAIF=0 -faligned-new -fbracket-depth=4096 -fcf-protection=none -Xclang -fno-pch-timestamp -Qunused-arguments -Wno-bool-operation -Wno-c++11-narrowing -Wno-constant-logical-operand -Wno-int-in-bool-context -Wno-non-pod-varargs -Wno-parentheses-equality -Wno-shadow -Wno-sign-compare -Wno-tautological-bitwise-compare -Wno-tautological-compare -Wno-uninitialized -Wno-unused-but-set-parameter -Wno-unused-but-set-variable -Wno-unused-parameter -Wno-unused-variable     -std=gnu++17 -c -o verilated_dpi.o /opt/homebrew/Cellar/verilator/5.044/share/verilator/include/verilated_dpi.cpp
c++ -Os  -I.  -MMD -I/opt/homebrew/Cellar/verilator/5.044/share/verilator/include -I/opt/homebrew/Cellar/verilator/5.044/share/verilator/include/vltstd -DVERILATOR=1 -DVM_COVERAGE=0 -DVM_SC=0 -DVM_TIMING=0 -DVM_TRACE=0 -DVM_TRACE_FST=0 -DVM_TRACE_VCD=0 -DVM_TRACE_SAIF=0 -faligned-new -fbracket-depth=4096 -fcf-protection=none -Xclang -fno-pch-timestamp -Qunused-arguments -Wno-bool-operation -Wno-c++11-narrowing -Wno-constant-logical-operand -Wno-int-in-bool-context -Wno-non-pod-varargs -Wno-parentheses-equality -Wno-shadow -Wno-sign-compare -Wno-tautological-bitwise-compare -Wno-tautological-compare -Wno-uninitialized -Wno-unused-but-set-parameter -Wno-unused-but-set-variable -Wno-unused-parameter -Wno-unused-variable     -std=gnu++17 -c -o verilated_vpi.o /opt/homebrew/Cellar/verilator/5.044/share/verilator/include/verilated_vpi.cpp
c++ -Os  -I.  -MMD -I/opt/homebrew/Cellar/verilator/5.044/share/verilator/include -I/opt/homebrew/Cellar/verilator/5.044/share/verilator/include/vltstd -DVERILATOR=1 -DVM_COVERAGE=0 -DVM_SC=0 -DVM_TIMING=0 -DVM_TRACE=0 -DVM_TRACE_FST=0 -DVM_TRACE_VCD=0 -DVM_TRACE_SAIF=0 -faligned-new -fbracket-depth=4096 -fcf-protection=none -Xclang -fno-pch-timestamp -Qunused-arguments -Wno-bool-operation -Wno-c++11-narrowing -Wno-constant-logical-operand -Wno-int-in-bool-context -Wno-non-pod-varargs -Wno-parentheses-equality -Wno-shadow -Wno-sign-compare -Wno-tautological-bitwise-compare -Wno-tautological-compare -Wno-uninitialized -Wno-unused-but-set-parameter -Wno-unused-but-set-variable -Wno-unused-parameter -Wno-unused-variable     -std=gnu++17 -c -o verilated_threads.o /opt/homebrew/Cellar/verilator/5.044/share/verilator/include/verilated_threads.cpp
python3 /opt/homebrew/Cellar/verilator/5.044/share/verilator/bin/verilator_includer -DVL_INCLUDE_OPT=include Vtop.cpp Vtop___024root__0.cpp Vtop__Dpi.cpp Vtop___024root__Slow.cpp Vtop___024root__0__Slow.cpp Vtop_target_pkg__Slow.cpp Vtop_target_pkg__0__Slow.cpp Vtop__Syms__Slow.cpp > Vtop__ALL.cpp
c++ -Os  -I.  -MMD -I/opt/homebrew/Cellar/verilator/5.044/share/verilator/include -I/opt/homebrew/Cellar/verilator/5.044/share/verilator/include/vltstd -DVERILATOR=1 -DVM_COVERAGE=0 -DVM_SC=0 -DVM_TIMING=0 -DVM_TRACE=0 -DVM_TRACE_FST=0 -DVM_TRACE_VCD=0 -DVM_TRACE_SAIF=0 -faligned-new -fbracket-depth=4096 -fcf-protection=none -Xclang -fno-pch-timestamp -Qunused-arguments -Wno-bool-operation -Wno-c++11-narrowing -Wno-constant-logical-operand -Wno-int-in-bool-context -Wno-non-pod-varargs -Wno-parentheses-equality -Wno-shadow -Wno-sign-compare -Wno-tautological-bitwise-compare -Wno-tautological-compare -Wno-uninitialized -Wno-unused-but-set-parameter -Wno-unused-but-set-variable -Wno-unused-parameter -Wno-unused-variable     -std=gnu++17 -c -o Vtop__ALL.o Vtop__ALL.cpp
c++  -Wl,-U,__Z15vl_time_stamp64v,-U,__Z13sc_time_stampv   verilator.o verilated.o verilated_dpi.o verilated_vpi.o verilated_threads.o Vtop__ALL.a   -Wl,-rpath,/Users/sayat/Documents/GitHub/tinyML_accelerator/.venv/lib/python3.13/site-packages/cocotb/libs -L/Users/sayat/Documents/GitHub/tinyML_accelerator/.venv/lib/python3.13/site-packages/cocotb/libs -lcocotbvpi_verilator  -pthread -lpthread   -o v2_system
rm Vtop__ALL.verilator_deplist.tmp
     -.--ns INFO     gpi                                ..mbed/gpi_embed.cpp:81   in set_program_name_in_venv        Did not detect Python virtual environment. Using system-wide Python interpreter
     -.--ns INFO     gpi                                ../gpi/GpiCommon.cpp:101  in gpi_print_registered_impl       VPI registered
     0.00ns INFO     cocotb                             Running on Verilator version 5.044 2026-01-01
     0.00ns INFO     cocotb                             Running tests with cocotb v1.9.2 from /Users/sayat/Documents/GitHub/tinyML_accelerator/.venv/lib/python3.13/site-packages/cocotb
     0.00ns INFO     cocotb                             Seeding Python random module with 1790180367
     0.00ns INFO     cocotb.regression                  Found test test_system.protocol_and_inference
     0.00ns INFO     cocotb.regression                  Found test test_system.complete_mlp_jobs
     0.00ns INFO     cocotb.regression                  running protocol_and_inference (1/2)
101070.00ns INFO     cocotb.regression                  protocol_and_inference passed
101070.00ns INFO     cocotb.regression                  running complete_mlp_jobs (2/2)
18939320.00ns INFO     cocotb.v2_system                   Strict MLP jobs: 100/1000
37279170.00ns INFO     cocotb.v2_system                   Strict MLP jobs: 200/1000
55617320.00ns INFO     cocotb.v2_system                   Strict MLP jobs: 300/1000
73956600.00ns INFO     cocotb.v2_system                   Strict MLP jobs: 400/1000
92294110.00ns INFO     cocotb.v2_system                   Strict MLP jobs: 500/1000
110633530.00ns INFO     cocotb.v2_system                   Strict MLP jobs: 600/1000
128974020.00ns INFO     cocotb.v2_system                   Strict MLP jobs: 700/1000
147315010.00ns INFO     cocotb.v2_system                   Strict MLP jobs: 800/1000
165647790.00ns INFO     cocotb.v2_system                   Strict MLP jobs: 900/1000
183989200.00ns INFO     cocotb.v2_system                   Strict MLP jobs: 1000/1000
183989200.00ns INFO     cocotb.regression                  complete_mlp_jobs passed
183989200.00ns INFO     cocotb.regression                  ********************************************************************************************
                                                           ** TEST                                STATUS  SIM TIME (ns)  REAL TIME (s)  RATIO (ns/s) **
                                                           ********************************************************************************************
                                                           ** test_system.protocol_and_inference   PASS      101070.00           0.48     208625.73  **
                                                           ** test_system.complete_mlp_jobs        PASS   183888130.00         936.71     196312.35  **
                                                           ********************************************************************************************
                                                           ** TESTS=2 PASS=2 FAIL=0 SKIP=0                183989200.00         937.51     196253.28  **
                                                           ********************************************************************************************
                                                           
- :0: Verilog $finish
INFO: Running command perl /opt/homebrew/bin/verilator -cc --exe -Mdir /Users/sayat/Documents/GitHub/tinyML_accelerator/work/phase2/sim_system -DCOCOTB_SIM=1 --top-module v2_system --vpi --public-flat-rw --prefix Vtop -o v2_system -LDFLAGS '-Wl,-rpath,/Users/sayat/Documents/GitHub/tinyML_accelerator/.venv/lib/python3.13/site-packages/cocotb/libs -L/Users/sayat/Documents/GitHub/tinyML_accelerator/.venv/lib/python3.13/site-packages/cocotb/libs -lcocotbvpi_verilator' --timing -Wno-fatal -GTIMEOUT_CYCLES=100 /Users/sayat/Documents/GitHub/tinyML_accelerator/.venv/lib/python3.13/site-packages/cocotb/share/lib/verilator/verilator.cpp /Users/sayat/Documents/GitHub/tinyML_accelerator/rtl/v2/target_pkg.sv /Users/sayat/Documents/GitHub/tinyML_accelerator/rtl/v2/requantizer.sv /Users/sayat/Documents/GitHub/tinyML_accelerator/rtl/v2/scratchpad.sv /Users/sayat/Documents/GitHub/tinyML_accelerator/rtl/v2/engine.sv /Users/sayat/Documents/GitHub/tinyML_accelerator/rtl/v2/command.sv /Users/sayat/Documents/GitHub/tinyML_accelerator/rtl/v2/system.sv /Users/sayat/Documents/GitHub/tinyML_accelerator/rtl/v2/uart_rx.sv /Users/sayat/Documents/GitHub/tinyML_accelerator/rtl/v2/uart_tx.sv /Users/sayat/Documents/GitHub/tinyML_accelerator/hardware/tang_nano_v2.sv in directory /Users/sayat/Documents/GitHub/tinyML_accelerator/work/phase2/sim_system
INFO: Running command make -C /Users/sayat/Documents/GitHub/tinyML_accelerator/work/phase2/sim_system -f Vtop.mk VM_TRACE=0 in directory /Users/sayat/Documents/GitHub/tinyML_accelerator/work/phase2/sim_system
INFO: Running command /Users/sayat/Documents/GitHub/tinyML_accelerator/work/phase2/sim_system/v2_system in directory /Users/sayat/Documents/GitHub/tinyML_accelerator/test/phase2
INFO: Results file: /Users/sayat/Documents/GitHub/tinyML_accelerator/work/phase2/sim_system/results.xml
