SayatAbdikul/Ushqyn/tools/phase6/hypothesis_cost.py

#!/usr/bin/env python3
"""Test an address-aware cost hypothesis within one fixed DeFiNES policy family.

All predictions are relative to a real full-model VWW anchor. Only the per-RUN
constant is calibrated, on two previously measured heights; held-out heights
are then measured with the unchanged native executable. This is not a general
cycle-accurate model, a board benchmark, or a new scheduling mechanism.
"""
from __future__ import annotations

import argparse
from collections import Counter
import copy
from dataclasses import asdict, replace
import json
import math
from pathlib import Path
import sys
import time

ROOT = Path(__file__).resolve().parents[2]
sys.path[:0] = [str(ROOT / 'compiler'), str(ROOT / 'tools/phase6')]
from matched_defines_baseline import (CMD, NATIVE, check_oracles, compile_config,
    compose, decode_fused, fixture, graph_identity, matched_model, native_measure,
    proxy, save, sha)
from matched_b1b2_generic import native_identity

BASE = ROOT / 'work/phase6/hypothesis-cost-v1'
FROZEN = ROOT / 'work/phase6/matched-baselines-v1'
HEIGHTS = (24, 16, 12, 8, 6, 4, 1)
TRAIN = (24, 12)
HELD_OUT = (16, 8, 4, 1)


def read_evidence(path):
    path = Path(path)
    return json.loads(path.read_text()), dict(file=str(path.relative_to(ROOT)), sha256=sha(path))


def validate_fixture(row):
    directory = ROOT / row['directory']
    for name, digest in row['files'].items():
        if sha(directory / name) != digest:
            raise ValueError(f'fixture changed: {directory / name}')
    if sorted(n['stall_seed'] for n in row['native']) != [0, 6063]:
        raise ValueError('fixture must have both distinct stall seeds')
    for native in row['native']:
        if (native['status'] != 'passed' or native['executable_sha256'] != sha(NATIVE)
                or native['fixture_files'] != row['files']):
            raise ValueError('unbound native evidence')
    if row['replay']['status'] != 'passed':
        raise ValueError('replay incomplete')


def scalar_line_trace(d):
    """Functional cache trace for the existing small general-CONV broadcast path.

    The implementation follows engine.sv line_index/gather_limit and paired
    output-channel traversal. It predicts hits/misses, not clock timings. No
    SRAM data values, calibration observations or native traces are consulted.
    """
    if not (d.opcode == 4 and d.kernel_h == d.kernel_w == 3 and
            d.output_c > 1 and d.count <= 128 and
            d.count == d.input_c * d.kernel_h * d.kernel_w):
        raise ValueError('unsupported descriptor for scalar cache hypothesis')
    oh = (d.input_h + d.pad_top + d.pad_bottom - d.kernel_h) // d.stride_h + 1
    ow = (d.input_w + d.pad_left + d.pad_right - d.kernel_w) // d.stride_w + 1
    if oh * ow * d.output_c != d.outputs:
        raise ValueError('descriptor geometry inconsistent')
    cache = {}
    f = Counter()
    for oc in range(0, d.output_c, 2):
        # Odd output channels consume the even channel's activation_tile.
        for oy in range(oh):
            for ox in range(ow):
                col = 0
                while col < d.count:
                    ic = col // (d.kernel_h * d.kernel_w)
                    ky = (col // d.kernel_w) % d.kernel_h
                    kx = col % d.kernel_w
                    y = oy * d.stride_h + ky - d.pad_top
                    x = ox * d.stride_w + kx - d.pad_left
                    address = d.input + ic * d.input_h * d.input_w + y * d.input_w + x
                    if y < 0 or x < 0 or y >= d.input_h or x >= d.input_w:
                        f['padding_steps'] += 1
                        col += 1
                        continue
                    take = min(d.kernel_w-kx, 8-address % 8, 8-col % 8,
                               d.count-col, d.input_w-x)
                    index = (y % 4)*8 + (address // 8) % 8
                    tag = address // 8
                    f['gather_steps'] += 1
                    if cache.get(index) != tag:
                        cache[index] = tag
                        f['line_misses'] += 1
                    else:
                        f['line_hits'] += 1
                    col += take
    return dict(f)


def features(code, record):
    f = Counter()
    descs = []
    for run in record['runs']:
        d, fused = decode_fused(bytes.fromhex(run['descriptor_hex']))
        if not fused:
            raise ValueError('expected common exact fused epilogue')
        descs.append(d)
        f.update(scalar_line_trace(d))
        f['runs'] += 1
        f['macs'] += d.outputs*d.count
    for i in range(0, len(code), 16):
        op, flags, _, ext, sram, length = CMD.unpack_from(code, i)
        if op:
            f['commands_without_halt'] += 1
        if op == 1:
            f['dma_commands'] += 1
            f['dma_beats'] += (length+7)//8
            f['dma_bytes'] += length
    return dict(f), descs


def instruction_score(f, per_run):
    # Two extra fixed SRAM states on a line miss; 3 states per ideal DMA beat
    # plus one DMA boundary cycle; four sequencer states per command. The
    # per-RUN fixed engine term is explicitly calibrated below, not inferred.
    return (2*f['line_misses'] + per_run*f['runs'] + 3*f['dma_beats'] +
            f['dma_commands'] + 4*f['commands_without_halt'])


def native_at(row, seed):
    return next(n for n in row['native'] if n['stall_seed'] == seed)
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
