SayatAbdikul/Ushqyn/tools/phase6/hypothesis_engine_overlap.py

#!/usr/bin/env python3
"""Isolated line-cache invalidation/LUT-load overlap; no board or frozen edits."""
import argparse
import json
import os
from pathlib import Path
import struct
import subprocess
import sys
import time
import xml.etree.ElementTree as ET

ROOT=Path(__file__).resolve().parents[2]
sys.path[:0]=[str(ROOT/'compiler'),str(ROOT/'tools/phase6')]
from matched_b1b2_generic import sha,NATIVE

BASE=ROOT/'work/phase6/engine-candidate-rtl-v1'
PARENT=ROOT/'work/phase6/pool-timing-v1/engine.sv'
PARENT_SHA='c347336ec58503f26abc47094289bd7926fcc5ed2515eca758a4b7dbc7f6d48a'
FINAL=ROOT/'work/phase6/matched-baselines-v1/b3-final/report.json'


def save(path,value):
    path.parent.mkdir(parents=True,exist_ok=True)
    path.write_text(json.dumps(value,indent=2,sort_keys=True)+'\n')


def once(source,old,new):
    if source.count(old)!=1:raise ValueError('RTL patch site changed')
    return source.replace(old,new,1)


def source_files(engine,only=False):
    paths=[ROOT/'rtl/v2/target_pkg.sv',ROOT/'rtl/v2/requantizer.sv',engine]
    if not only:
        paths.extend(ROOT/'rtl/v2'/name for name in ('scratchpad.sv','tile_dma.sv','tiled_core.sv',
            'command.sv','tile_sequencer.sv','tiled_host_bridge.sv'))
    return paths


def prepare(output=BASE):
    output=Path(output).resolve();output.mkdir(parents=True,exist_ok=True)
    if sha(PARENT)!=PARENT_SHA:raise ValueError('selected engine changed')
    source=once(PARENT.read_text(),
        '    wire clearing_line=VALID_IN_BRAM&&state==LINE_CLEAR;\n'
        '    wire [LINE_BITS-1:0] line_write_index=clearing_line?line_clear_index:line_fill_index;',
        '''    // LUT and line-cache storage have distinct write ports. During the
    // mandatory 256-byte fused-table reload, clear each cache entry exactly
    // once. Larger caches retain the original sequential invalidation path.
    wire lut_line_clear=VALID_IN_BRAM&&(LINE_ENTRIES<=256)&&
        state==F_L_BYTES&&(32'(lut_index)<LINE_ENTRIES);
    wire clearing_line=VALID_IN_BRAM&&(state==LINE_CLEAR||lut_line_clear);
    wire [LINE_BITS-1:0] line_write_index=lut_line_clear?LINE_BITS'(lut_index):
        (clearing_line?line_clear_index:line_fill_index);''')
    source=once(source,
        '                        line_clear_index<=0;state<=VALID_IN_BRAM?LINE_CLEAR:GEOM1;',
        '''                        line_clear_index<=0;
                        state<=(VALID_IN_BRAM&&!(fused_activation&&LINE_ENTRIES<=256))?
                            LINE_CLEAR:GEOM1;''')
    engine=output/'engine.sv'
    if engine.exists() and engine.read_text()!=source:raise ValueError('candidate already differs')
    engine.write_text(source)
    # Exhaustive control-level check of parameterized entry coverage. Default
    # native tests below exercise the real 256-entry configuration.
    coverage=[]
    for entries in (32,64,128,192,256,512):
        touched=[i for i in range(256) if entries<=256 and i<entries]
        if entries<=256 and touched!=list(range(entries)):raise AssertionError('missing invalidation')
        if entries>256 and touched:raise AssertionError('larger-cache fallback changed')
        coverage.append(dict(entries=entries,overlapped_entries=len(touched),
            sequential_fallback=entries>256))
    record=dict(status='prepared',physical_board=False,parent=str(PARENT.relative_to(ROOT)),
        parent_sha256=sha(PARENT),engine_sha256=sha(engine),parameter_coverage=coverage,
        mechanism='invalidate line-cache BRAM while independent fused activation LUT BRAM loads; no arithmetic, ABI, layout or memory capacity change',
        expected_default_saved_engine_cycles_per_fused_descriptor=256,
        limitations=['Parameterized invalidation coverage is a control-model check; native/engine RTL tests use default256 entries.',
                     'No physical routing, resource measurement or board result is claimed.'])
    save(output/'identity.json',record)
    return output,engine
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
