SayatAbdikul/Ushqyn/(commit log)

2026-05-05 compiler: clean golden_model debug residue; add CNN ops to disassembler
    Patch A of the CNN compiler-fix series (independent cleanup; no behavior
    change for correct inputs).
    golden_model.py
    - Remove committed apology comment block + always-on [DBG_CONV2D_RUN]
    print left over from a prior LLM edit inside the CONV2D_RUN decode path.
    - Add module-level DEBUG_GOLDEN gate driven by GOLDEN_DEBUG=1 env var.
    - Wrap [DBG_GOLDEN] / [DBG_GOLDEN_CONV] / [DBG_GOLDEN_POOL] prints in
    gemv / conv2d / maxpool behind the gate. Tests now run quietly by
    default; opt-in tracing via `GOLDEN_DEBUG=1 pytest …`.
    disassembler.py
    - Add CONV2D_CFG (0x06), CONV2D_RUN (0x07), MAXPOOL (0x08) decoder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
2026-05-05 compiler: fix CNN bias data-flow + add unified DRAM walker
    Patch B of the CNN compiler-fix series (atomic data-flow fix + test).
    THE BUG (verified empirically pre-patch on small_cnn_model.onnx)
    ================================================================
    Every CONV2D_RUN read its bias from the wrong DRAM offset, and the
    final FC GEMV read its bias as zeros. Two coupled root causes:
    (1) compile.py emitted Conv biases TWICE — once via the generic
    initialiser loop (line 153) and again via the Conv-specific block
    (line 268). Each load bumped bias_counter, so addresses drifted.
    The Conv block then bound CONV2D_RUN's b_buf to the SECOND (wrong)
    load, leaving the correctly-l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
2026-05-06 compiler: fix Conv→Relu lookahead skipping non-consumer nodes
    Patch D — adjacent to the CNN compiler-fix series. Closes the last
    remaining int8-vs-float32 accuracy gap on trained CNNs.
    THE BUG (was Bug 8 in the analysis, surfaced after Patch B)
    ===========================================================
    compile.py's single-step Conv→Relu fusion lookahead broke at the
    first non-skip node it encountered. For ONNX-exported CNNs with a
    Reshape-before-Gemm pattern, torch.onnx.export emits a Constant node
    for Reshape's shape input; topological_sort places that Constant
    right after Conv1 because it has no graph dependencies. The lookahead
    then saw a non-Relu node, hit `break`, and emitted CO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
2026-05-06 rtl: relu_flag plumbing for CONV2D_RUN + bring up conv2d_execution
    Patch F of the RTL fix series. Closes Bug R1 (CONV2D_RUN.relu_flag never
    decoded, plumbed, or applied) and lands the first cut of the CONV2D
    execution unit and its testbench.
    THE BUG (R1)
    ============
    The compiler emits CONV2D_RUN with relu_flag=1 at bit 25 for both convs
    of SmallCNN (after Patch D), but the RTL stack discarded the bit at every
    layer:
    - i_decoder.sv only decoded dest/x/w/b for opcode 0x07
    - tinyml_accelerator_top.sv had no ex_relu_flag latch
    - modular_execution_unit.sv had no relu_flag input port
    - conv2d_execution.sv had no relu_flag input or post-quantization clamp
    Result: every Conv output kept it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
    [conv2d_execution.sv, conv2d_execution_tb.cpp, conv2d_execution_tb_wrapper.sv, modular_execution_unit.sv, tinyml_accelerator_top.sv]
2026-05-06 rtl: NCHW MaxPool + bring up maxpool_execution
    Patch G of the RTL fix series. Closes Bug R2 (MaxPool layout mismatch
    with conv2d_execution's NCHW output).
    THE BUG (R2)
    conv2d_execution.sv writes its output in NCHW order (channel outermost):
    linear_idx = oc * total_out_pixels + oh * out_w + ow
    maxpool_execution.sv read it as NHWC (channel innermost):
    vec_random_read_addr = ih * fmap_w * in_channels + iw * in_channels + c
    and emitted output in NHWC order (c innermost). For a 4-channel 26×26
    NCHW buffer, element (c=1, h=0, w=0) is at addr 676, but maxpool
    fetched addr 1 — which in NCHW is (c=0, h=0, w=1). Every pool window
    reduced over completely wrong neighbourhoods, and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
    [maxpool_execution.sv, maxpool_execution_tb.cpp, maxpool_execution_tb_wrapper.sv]
2026-05-06 rtl: widen LOAD_V/STORE length to 18 bits (R3)
    Patch H of the RTL fix series. Closes Bug R3 (latent capability gap):
    i_decoder's `length_or_cols` was 10-bit while the toolchain (compiler
    Patch A) standardised LOAD_V/STORE length to 18-bit at [27:10]. Inputs
    > 1023 elements would silently truncate.
    THE FIX
    =======
    rtl/i_decoder.sv
    - `length_or_cols` widened from [9:0] to [17:0].
    - LOAD_V (0x01) and STORE (0x03): decode `instr[27:10]` instead of
    `instr[19:10]`. 18-bit per assembler/golden_model contract.
    - LOAD_M / GEMV / RELU still encode their respective fields at 10
    bits, so those branches now zero-extend `{8'b0, instr[...]}` to
    keep the carrier consistent.
    rtl/tinyml_a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
    [load_execution.sv, load_v.sv, modular_execution_unit.sv, store.sv, store_execution.sv, tinyml_accelerator_top.sv]
2026-05-06 rtl: parameterize accum_ram depth + overflow assert (R4)
    Patch I of the RTL fix series. Closes Bug R4 (latent capability gap):
    conv2d_execution.sv hardcoded the per-output-element int32 accumulator
    RAM at [0:4095]. SmallCNN's largest layer (4·26·26 = 2704 elements
    fits, 8·11·11 = 968 fits) but anything larger silently overflowed.
    rtl/execution_unit/conv2d_execution.sv
    - New `parameter ACCUM_DEPTH = 4096` (default preserves the existing
    depth so no instantiation needs to change).
    - `accum_ram` declared as [0:ACCUM_DEPTH-1] instead of [0:4095].
    - In INIT_CONV state, $error fires if the runtime geometry would
    require more than ACCUM_DEPTH entries:
    out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
    [conv2d_execution.sv]
2026-05-06 rtl: bump VECTOR_BUFFER_WIDTH to 32768 + thread through exec units
    Patch J — closes the integration gap that the F+G+H+I unit tests left
    open. After Patches F (relu_flag), G (NCHW maxpool), H (18-bit length),
    I (parameterized accum_ram), each execution unit was bit-exact against
    the golden model in isolation, but end-to-end SmallCNN inference still
    diverged: predicted class differed (RTL=2 vs Golden=7) with max
    element-wise error 71. Root cause was a config issue downstream from
    the unit fixes, not a unit bug.
    THE BUG
    SmallCNN's conv1 output is 4 channels × 26 × 26 = **2704 bytes**, but
    the per-vector-buffer width was 8192 bits = **1024 bytes**. Writes past
    byte 1024 wrapped sil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
    [conv2d_execution.sv, maxpool_execution.sv, modular_execution_unit.sv]
2026-05-06 docs: update for 8-opcode ISA, CNN execution units, and Patches A–J
    The README and architecture docs claimed a 5-instruction ISA with MLP-only
    support, which hasn't been accurate since the CNN compiler+RTL series
    (Patches A–D, F–J) landed. Sweep them to match the current state.
    README.md
    - Status table: MLP (FPGA validated 89 MHz, 95% MNIST 10K) vs SmallCNN
    (sim RTL bit-exact vs golden, ~94–96% accuracy).
    - 8-opcode ISA table (LOAD_V, LOAD_M, STORE, GEMV, RELU, CONV2D_CFG,
    CONV2D_RUN with relu_flag, MAXPOOL).
    - Two RTL paths: rtl/execution_unit/ (CNN-capable, sim only) vs
    src/ + rtl/fpga_modules/ (MLP only, synthesizable).
    - Patches A–D, F–J table summarising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
2026-05-06 Add random buffer read and CNN test support
    Introduce a combinational random-access read port and per-buffer index reset to buffer_file, and expose the random-read interface through buffer_controller so callers can read buffer words by address. Add a (* use_dsp = "yes" *) hint to the PE multiplier to guide synthesis. Update the test infrastructure: expand DRAM offsets (add conv_weights), rework heavy tests to use a SmallCNN (train/load weights, export ONNX, save conv weights to DRAM) and update assembly filenames. Update the heavy_test Makefile to add a Verilator -Wno-UNSIGNED flag, include accelerator_config_pkg.sv, and add conv2d/maxpool execution sources. Misc formatting/cleanup in accele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
    [buffer_controller.sv, buffer_file.sv, pe.sv]
2026-05-08 Add ISA spec and centralize instruction encoding
    Introduce compiler/isa_spec.py as the single source of truth for opcodes, fields and bit layouts. Refactor assembler, disassembler and golden-model decoder to read from isa_spec (preserve backwards-compatible OPCODES dict in assembler). Add tools/generate_i_decoder.py to emit rtl/i_decoder.sv and commit a regenerated rtl/i_decoder.sv. Replace ad-hoc bit fiddling across the codebase with isa_spec.encode / decode_fields helpers and update test and runtime callers (train_and_eval_cnn, test_cnn_golden). Add compiler/test_isa_spec.py to assert cross-consistency (assembler, disassembler, golden model, and RTL generator). Update README and docs to do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
2026-05-08 Add profile-based accelerator config (sim/fpga)
    Replace the single auto-generated accelerator_config with a hand-edited, profile-based module exposing SimProfile and FpgaProfile and selecting the active profile via TINYML_PROFILE. Update generate_config.py to source parameters from SimProfile and only emit the RTL package. Remove the legacy test/heavy_test_fpga/accelerator_config.py override and instead export/set TINYML_PROFILE in the Makefile and test to ensure FPGA profile selection. Add smoke tests (compiler/test_accelerator_config.py) to validate profiles and switching. Also stop ignoring compiler/accelerator_config.py in .gitignore and adjust test_full_mnist.py to set the env var at im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
2026-05-09 Add liveness-based buffer allocator
    Introduce a liveness-based linear-scan buffer allocator to replace the fragile hand-rolled ping-pong scheme. Adds compiler/buffer_allocator.py (with compute_last_use, BufferAllocator, and allocate_buffers) and unit tests compiler/test_buffer_allocator.py that cover aliasing, reservation, pool disjointness, out-of-buffers failure, and branching/residual patterns. Update compiler/compile.py to use the new allocator (remove manual ping-pong buffers, use assignments[tensor_name] for LOAD_M/LOAD_V/GEMV/CONV2D/RELU/MAXPOOL/STORE, handle fused/large Relu aliasing, and introduce RELU_MAX_LENGTH). Also add the new test to the Makefile test-compiler target and bump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
2026-05-09 Limit initializer buffers to Conv/Gemm/MatMul
    Stop treating arbitrary 1-D initializers as biases/weights. Introduce INITIALIZER_OPS and update BufferAllocator, compile.py, and dram.py to only allocate/load initializers for Conv, Gemm, and MatMul (Conv continues to handle its own loads). This prevents op-parameter initializers (e.g. Squeeze axes emitted by newer ONNX exporters) from being allocated to DRAM or buffer slots and avoids spurious LOAD_V/LOAD_M emissions. Add a regression test that builds a synthetic graph with a Squeeze axes initializer to assert it is not written to DRAM or assigned a buffer.
2026-09-23 feat(phase-2): add routed Tang Nano INT8 MLP accelerator candidate
    Implement the v2 target ABI, compiler lowering, eight-lane RTL, UART command transport, host tools, and a reproducible routed bitstream. Record 119 software tests, directed RTL checks, 1000 exact simulated MLP jobs, and Gowin timing/resource evidence. Keep physical board validation and research novelty gates explicitly open.
2026-09-23 feat(phase-3): add routed SmallCNN accelerator candidate
    Add on-chip Conv/MaxPool execution, physical SRAM planning, target-aware compiler lowering, SmallCNN fixtures, and reproducible routed evidence. Verify 1,000 exact simulated jobs and a 27 MHz route; keep physical-board and energy gates open.
    [collect_evidence.py, engine.sv, host.py]
2026-09-23 feat(phase-4): add routed audio-vision kernels and tile DMA prototype
    Extend the target with depthwise convolution, unpadded average pooling and Clip; preserve one INT8 MAC array. Add exact pinned-geometry RTL tests, a standalone abstract-port tile transfer core, frozen inventory audit and source-hashed Gowin evidence. Keep SDRAM integration, burst overlap, full-model runs and physical measurements open.
2026-09-23 phase5: pin balanced model-switch plan and evidence audit
2026-09-23 board: add physical inference runner and record USB bring-up
2026-09-23 fix(board): correct active-high KEY1 reset and reproducible UART build
    [tang_nano_v2.sv, uart_loopback.sv]
2026-09-23 test(board): validate physical kernels, memory and archived oracle outputs
2026-09-23 board: archive 13000 exact inferences and Tang Nano physical evidence
2026-09-23 Phase 3: archive Tang Nano line-buffer board validation
2026-09-23 Record Gowin Phase 3 power estimate and assumptions
2026-09-24 phase4: prove integrated full-tile SDRAM DMA on board
2026-09-25 phase4: validate real KWS and VWW tiles in boardless RTL
2026-09-25 phase4: validate tiled SDRAM inference and guarded DMA overlap on board
2026-09-26 phase5: chain full accuracy runs after switch validation
2026-09-26 phase5: queue matched baseline probes after accuracy
2026-09-26 research: freeze AD data and calibration provenance
2026-09-26 research: start boardless phase 6 schedule validation
2026-09-26 research: archive phase 6 boardless results and remaining gates
2026-09-26 research: archive phase 6 optimization evidence and board candidates
2026-09-27 feat: complete phase 6 optimization campaign
    Add exact compiler and RTL candidates, routed Tang Nano 20K images, short physical screens, burst UART transfer, bounded no-go gates, and hash-verified research evidence.
    [algorithm_experiments.py, audit_writeback.py, chain_resident.py, check_burst_inference.py, clock_experiment.py, combined_next.py, combined_scalar_uart.py, combined_spec.py]
2026-09-27 Optimize fused TinyML accelerator and verify on Tang Nano 20K
2026-09-28 Archive matched VWW finalist board campaign
2026-10-01 fix(compiler): stream calibration samples without duplicate arrays
2026-10-01 feat(phase6): select the board-validated 27 MHz accelerator
